cruunnerr/CrallyBoard/3D Animated Pictures/01_Top.png

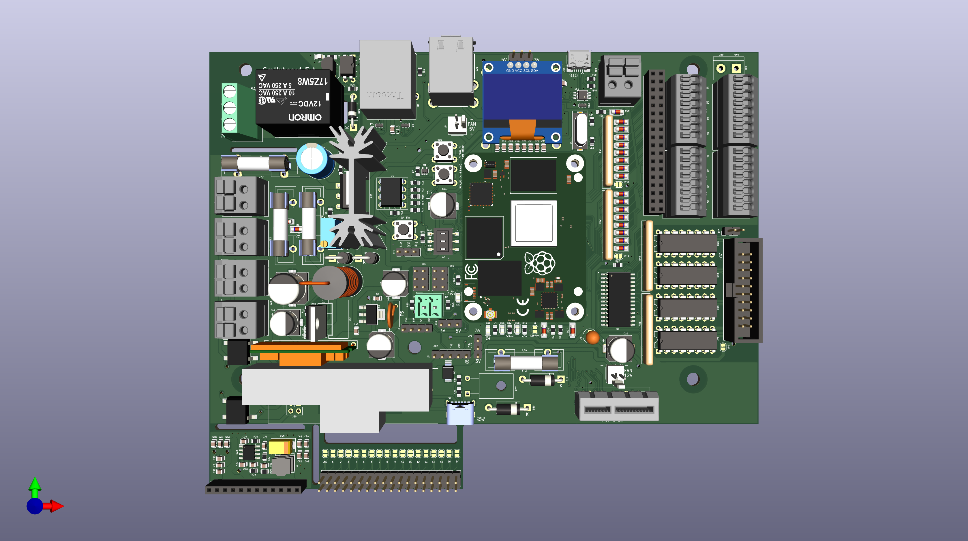
3D Animated Pictures/01_Top.png
