cruunnerr/CrallyBoard/3D Animated Pictures/03_Inputs:Outputs.png

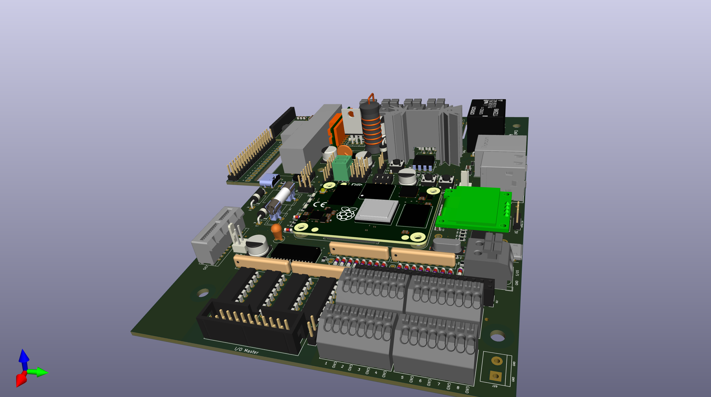
3D Animated Pictures/03_Inputs:Outputs.png
