cruunnerr/CrallyBoard/3D Animated Pictures/02_Main_Connectors.png

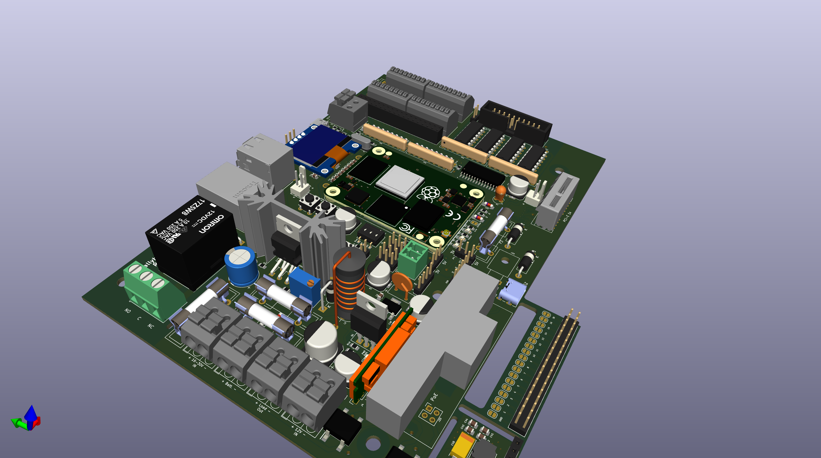
3D Animated Pictures/02_Main_Connectors.png
