cruunnerr/CrallyBoard/3D Animated Pictures/04_Data_Connectors.png

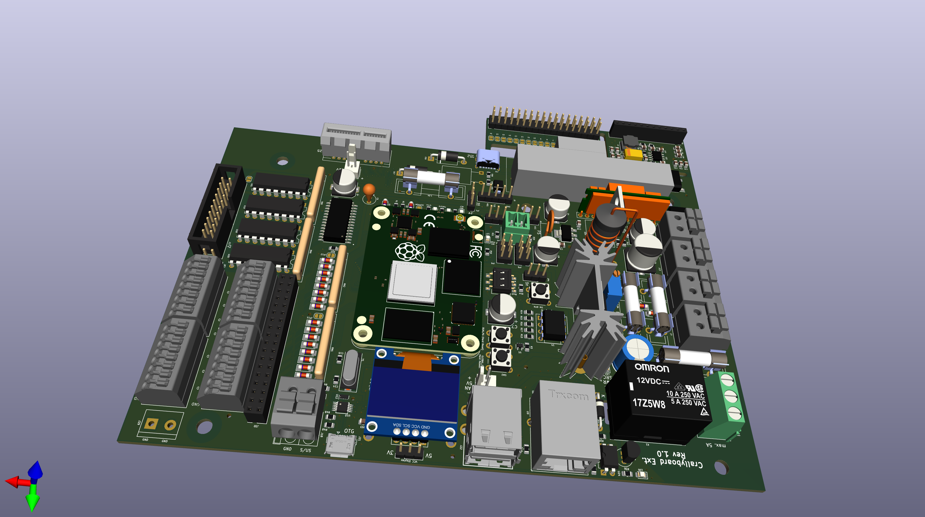
3D Animated Pictures/04_Data_Connectors.png
