cruunnerr/CrallyBoard/3D Animated Pictures/05_Backside.png

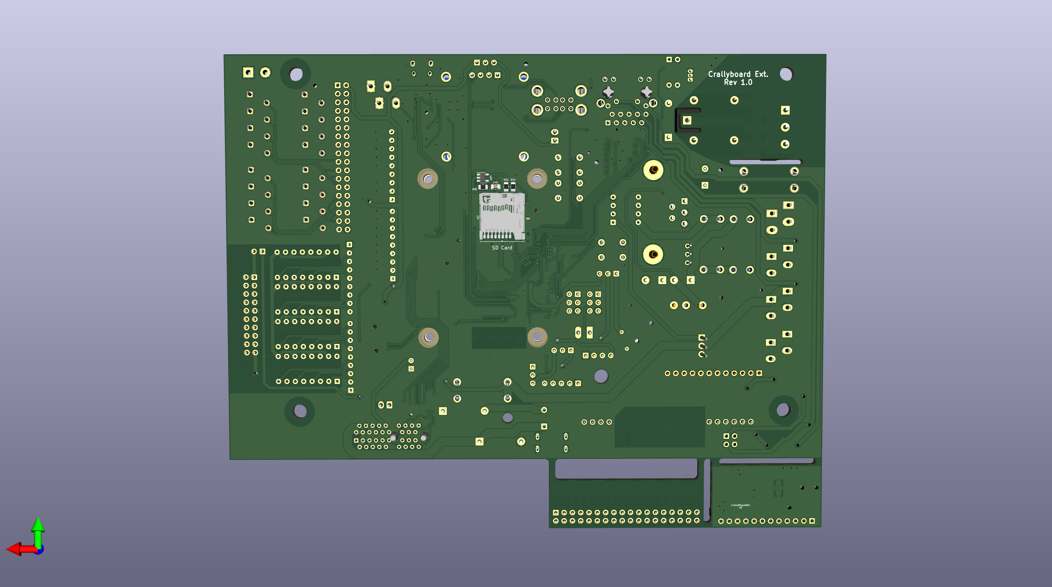
3D Animated Pictures/05_Backside.png
