cruunnerr/CrallyBoard/cam_server-Assembly.pdf

1 | 2 | 3 | 4 | 5 | 6 1 | 2 | 3 | 4 | 5 | 6 ABCD | ABCD Date: 2022-10-13 KiCad E.D.A. kicad (6.0.4-0) Size: A4 | Rev: 1.0
100uF C45 | 220R | R³ Jumper_2_Bridged G⁵LE⁻¹ | K¹

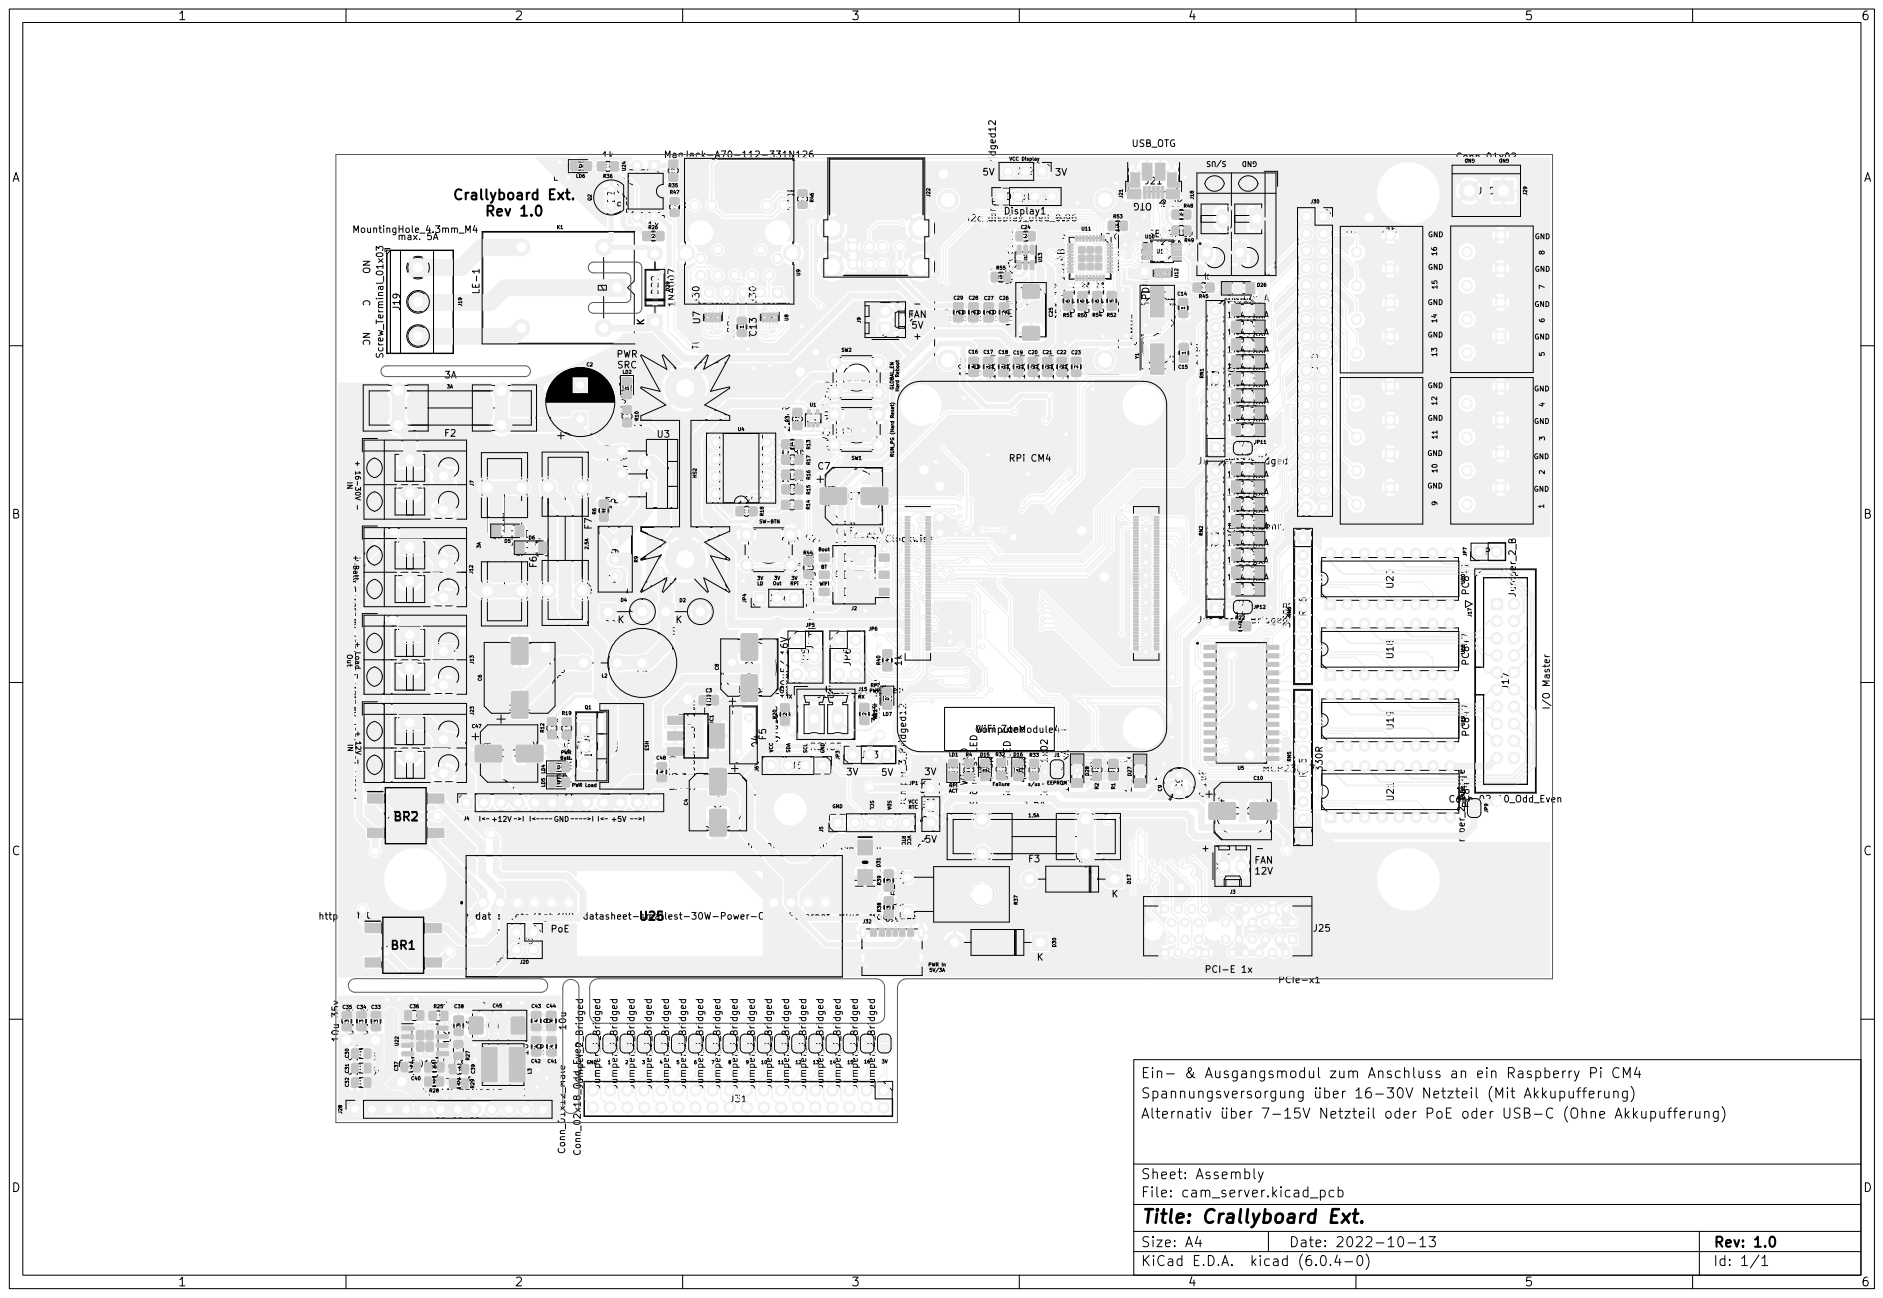
[picture p6: page 1]

EEPROM Crallyboard Ext. Rev 1.0

s/us RUN_PG ⁽Hard Reset) max. 5A

GND GND ⁺ ¹⁶⁻³0V - IN

https://silvertel.com/images/datasheets/Ag5300-datasheet-smallest-30W-Power-Over-Ethernet-Plus-Module-PoEplusPD.pdf U25

Ein- & Ausgangsmodul zum Anschluss an ein Raspberry Pi CM4
Spannungsversorgung über 16-30V Netzteil (Mit Akkupufferung)
Alternativ über 7-15V Netzteil oder PoE oder USB-C (Ohne Akkupufferung)

Sheet: Assembly
File: cam_server.kicad_pcb
Id: 1/1 Title: Crallyboard Ext.

1 | 2 | 3 | 4 | 5 | 6

A

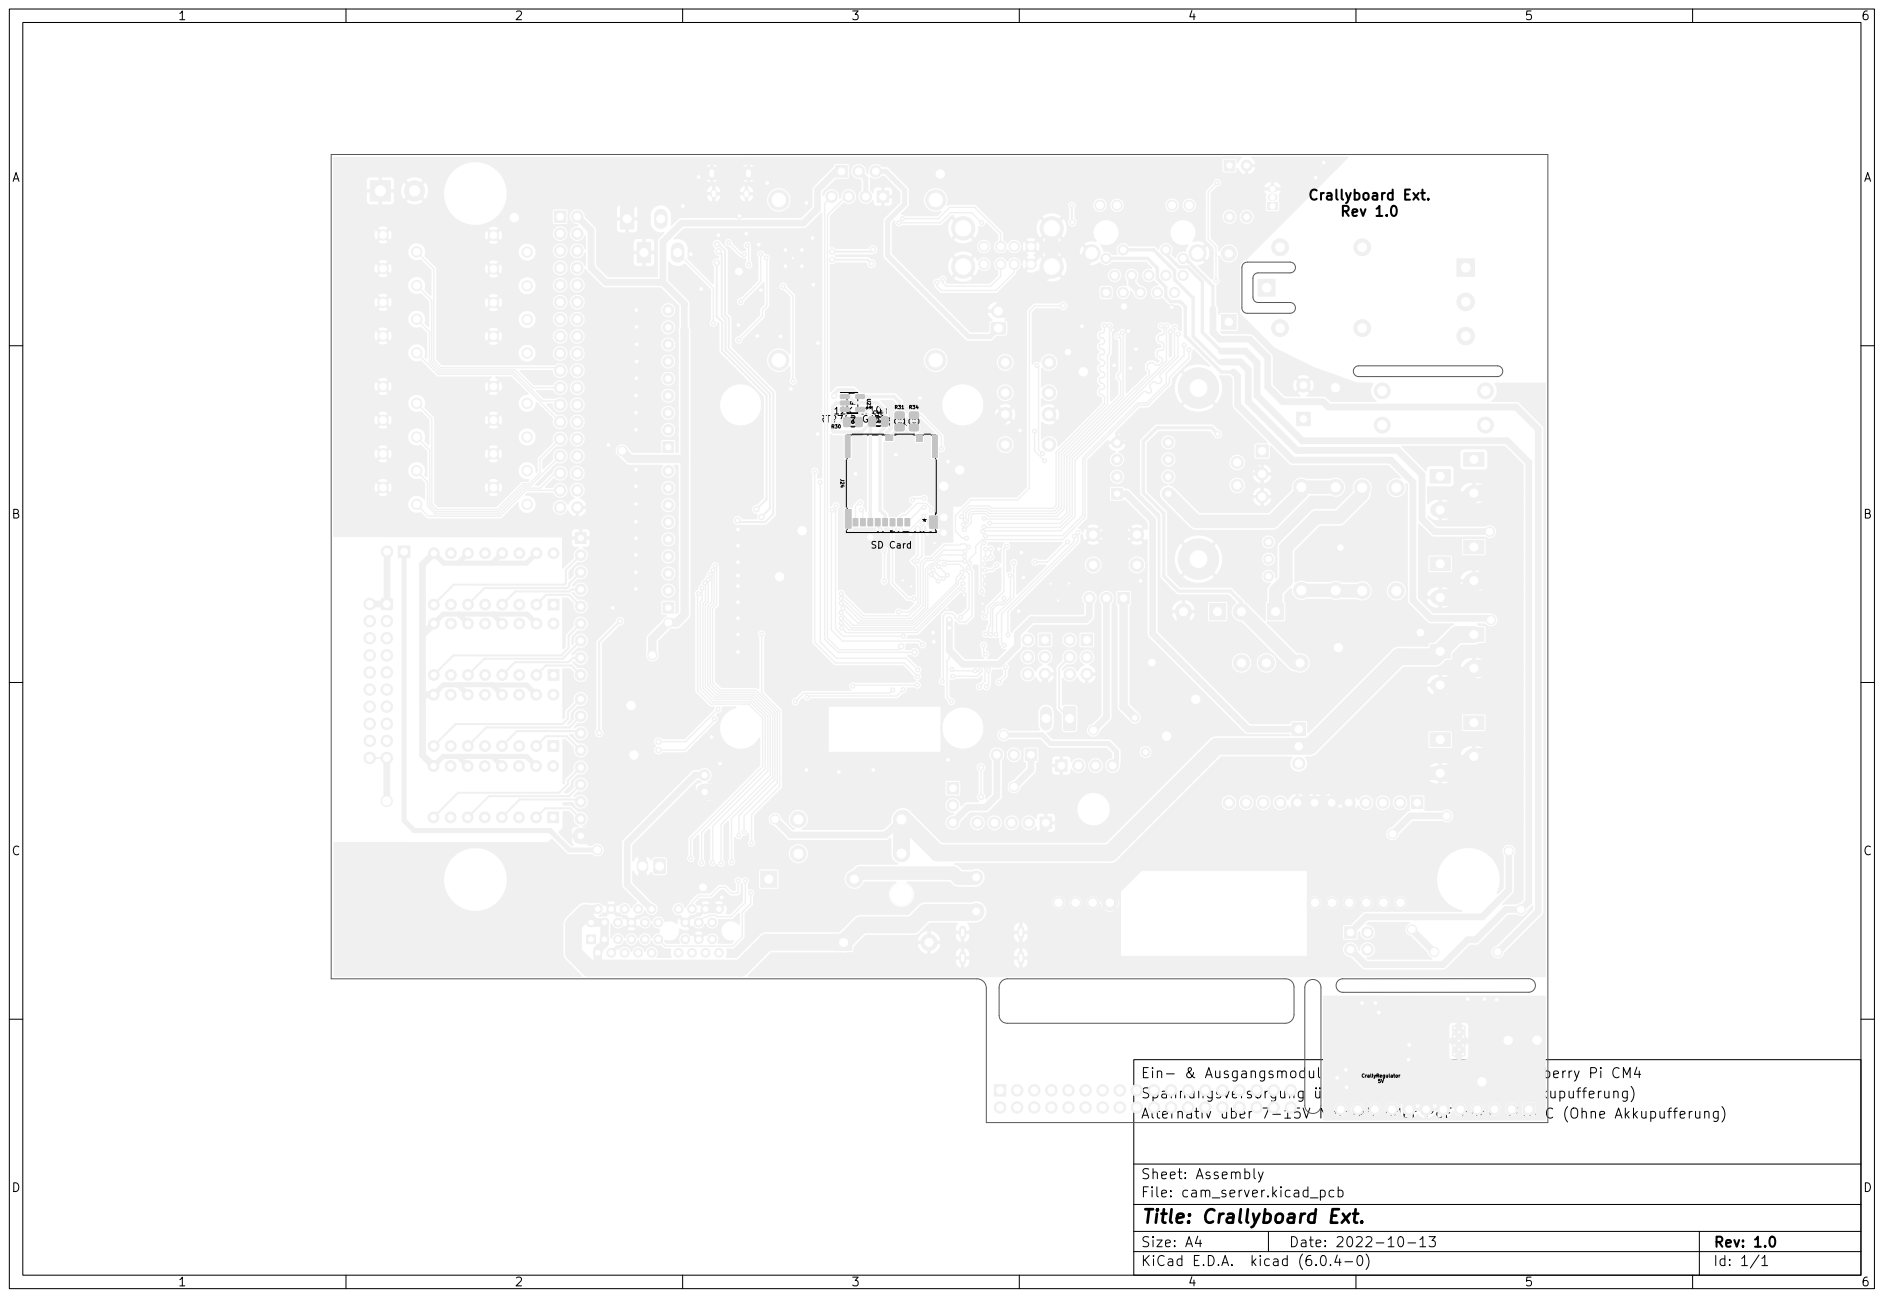
[picture p7: page 2]
D Date: 2022-10-13 KiCad E.D.A. kicad (6.0.4-0) Size: A4; Rev: 1.0; R34RT9742AGJ5F; CrallyRegulator 5V; SD Card; Crallyboard Ext. Rev 1.0

Ein- & Ausgangsmodul zum Anschluss an ein Raspberry Pi CM4
Spannungsversorgung über 16-30V Netzteil (Mit Akkupufferung)
Alternativ über 7-15V Netzteil oder PoE oder USB-C (Ohne Akkupufferung)

Sheet: Assembly
File: cam_server.kicad_pcb
Id: 1/1 Title: Crallyboard Ext.

1 | 2 | 3 | 4 | 5 | 6 1 | 2 | 3 | 4 | 5 | 6 ABCD | ABCD Date: 2022-10-13 KiCad E.D.A. kicad (6.0.4-0) Size: A4 | Rev: 1.0
100uF C45 | 220R | R³ Jumper_2_Bridged G⁵LE⁻¹ | K¹

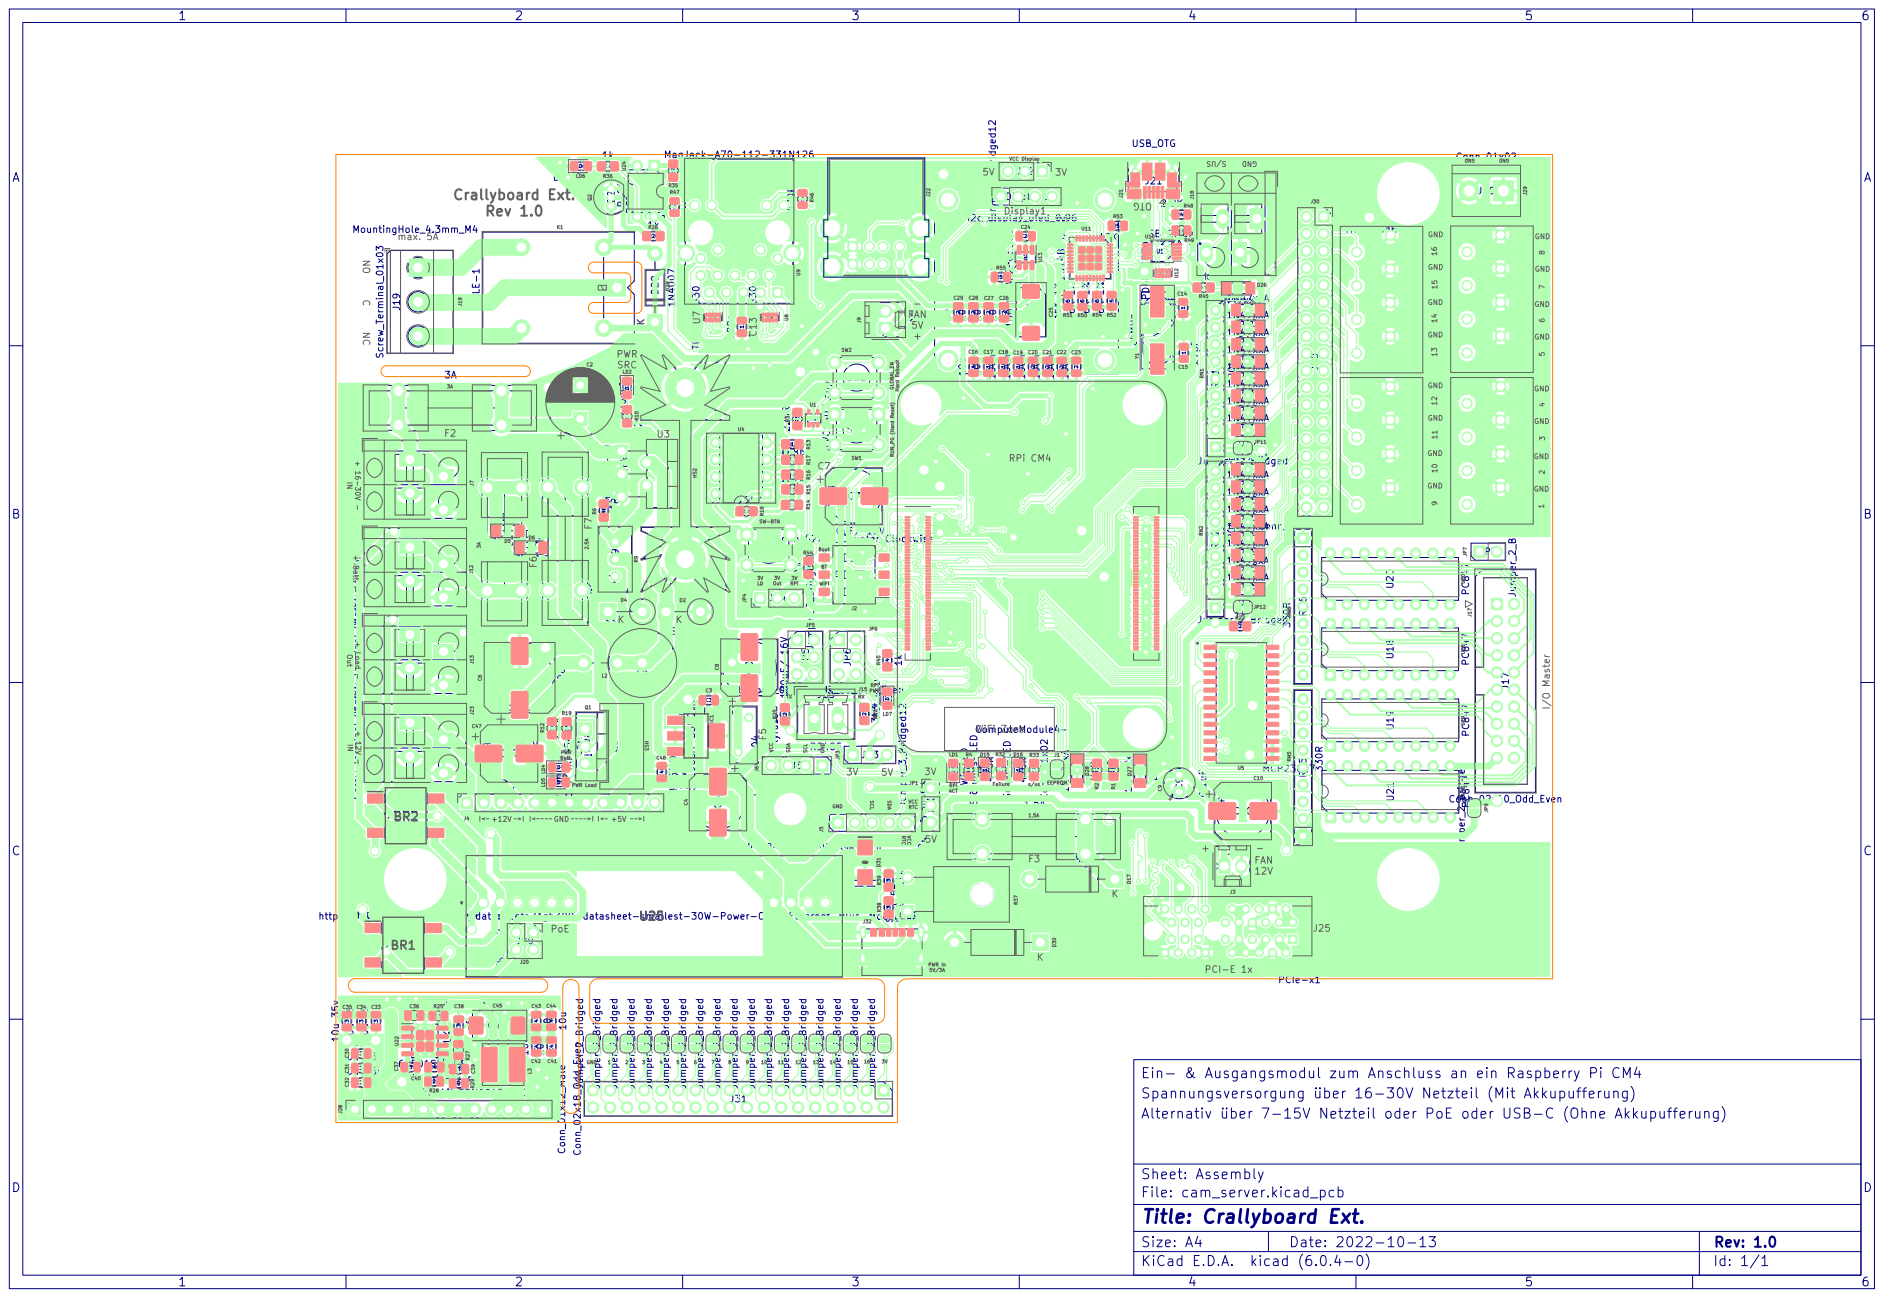
[picture p8: page 3]

EEPROM Crallyboard Ext. Rev 1.0

s/us RUN_PG ⁽Hard Reset) max. 5A

GND GND ⁺ ¹⁶⁻³0V - IN

https://silvertel.com/images/datasheets/Ag5300-datasheet-smallest-30W-Power-Over-Ethernet-Plus-Module-PoEplusPD.pdf U25

Ein- & Ausgangsmodul zum Anschluss an ein Raspberry Pi CM4
Spannungsversorgung über 16-30V Netzteil (Mit Akkupufferung)
Alternativ über 7-15V Netzteil oder PoE oder USB-C (Ohne Akkupufferung)

Sheet: Assembly
File: cam_server.kicad_pcb
Id: 1/1 Title: Crallyboard Ext.

1 | 2 | 3 | 4 | 5 | 6

A

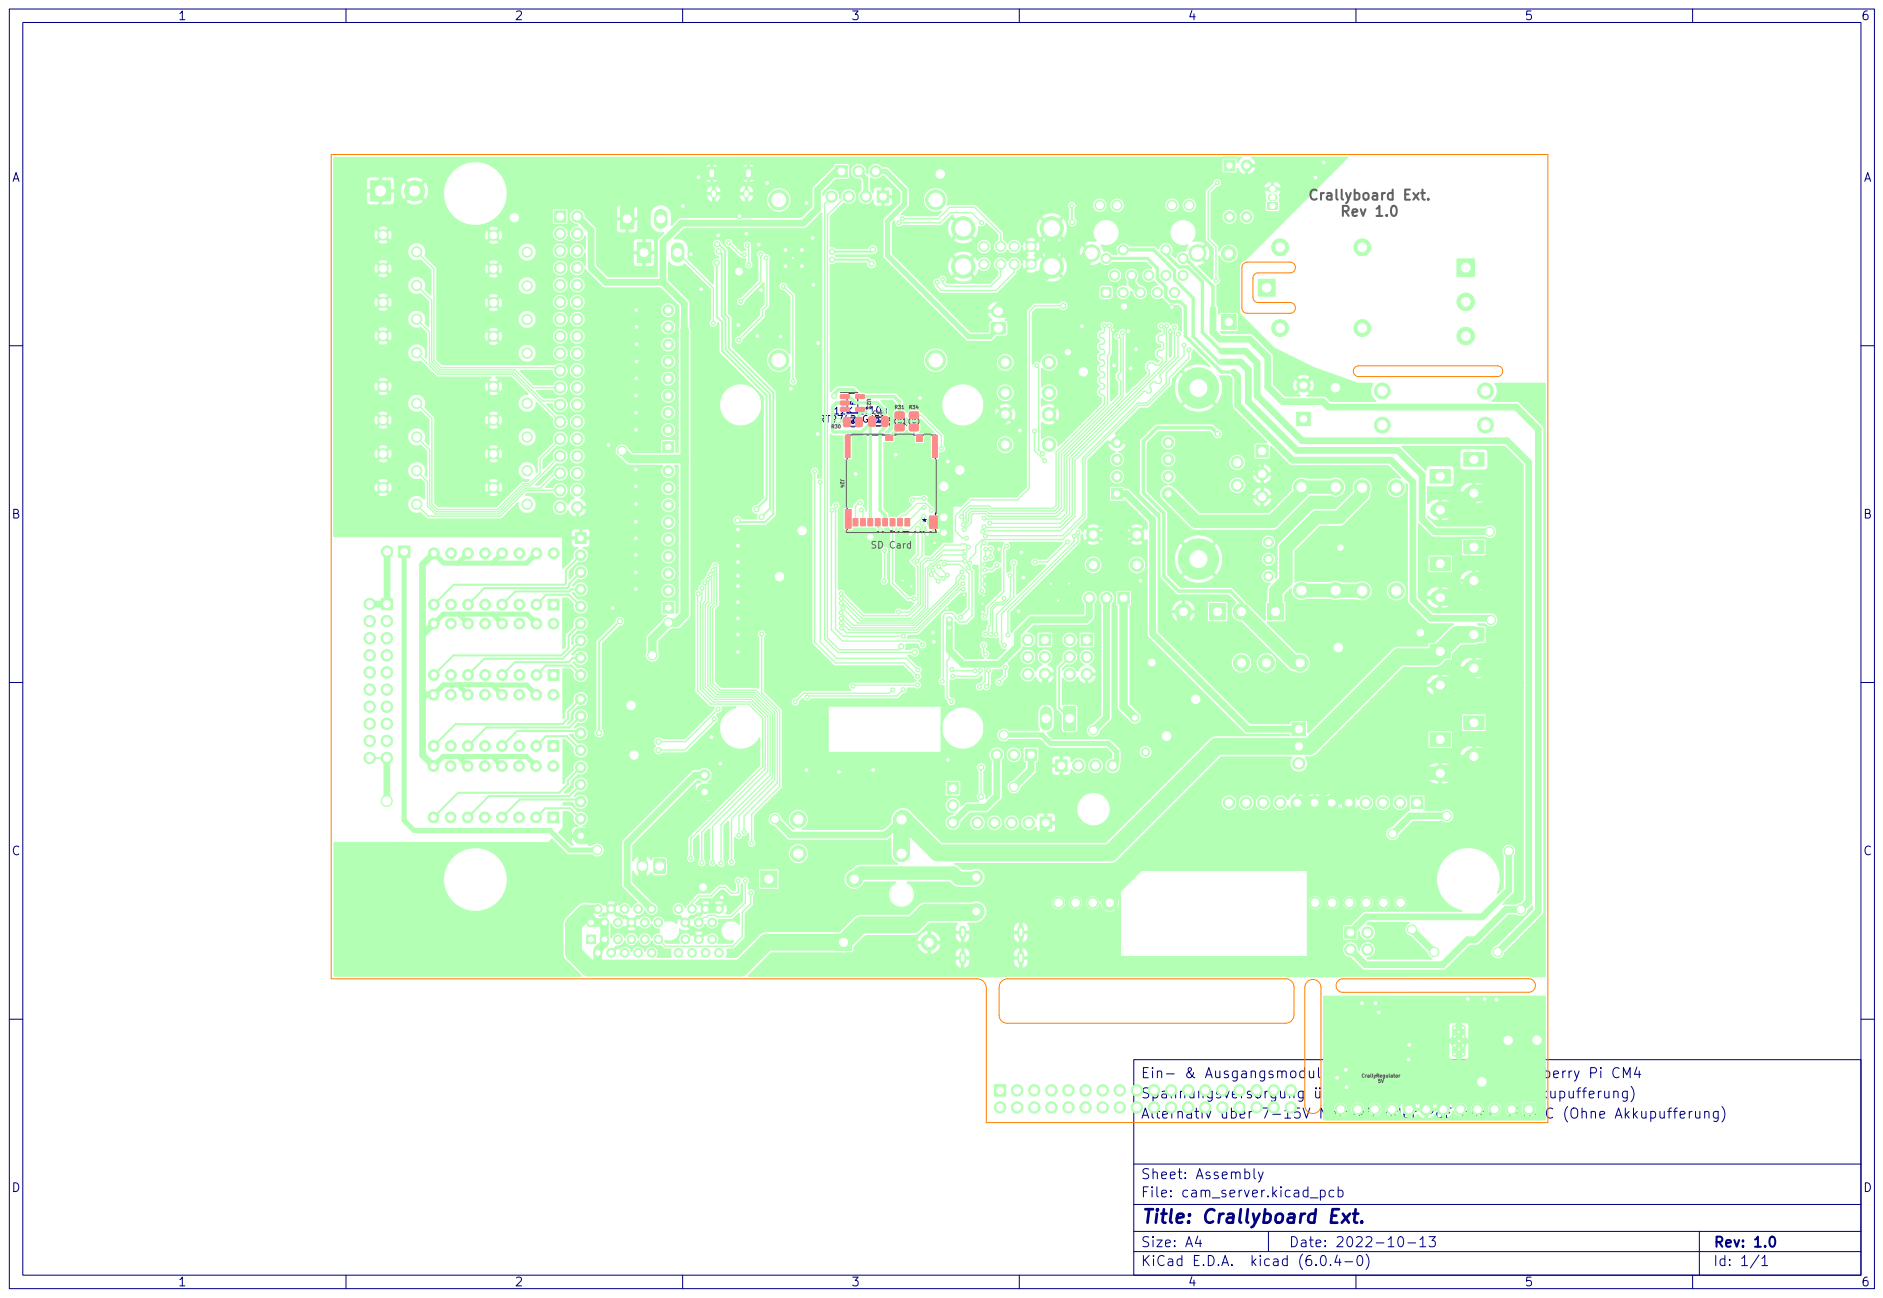
[picture p9: page 4]
D Date: 2022-10-13 KiCad E.D.A. kicad (6.0.4-0) Size: A4; Rev: 1.0; R34RT9742AGJ5F; CrallyRegulator 5V; SD Card; Crallyboard Ext. Rev 1.0

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

Sheet: Assembly
File: cam_server.kicad_pcb
Id: 1/1 Title: Crallyboard Ext.

SD Card | Crallyboard Ext. Rev 1.0

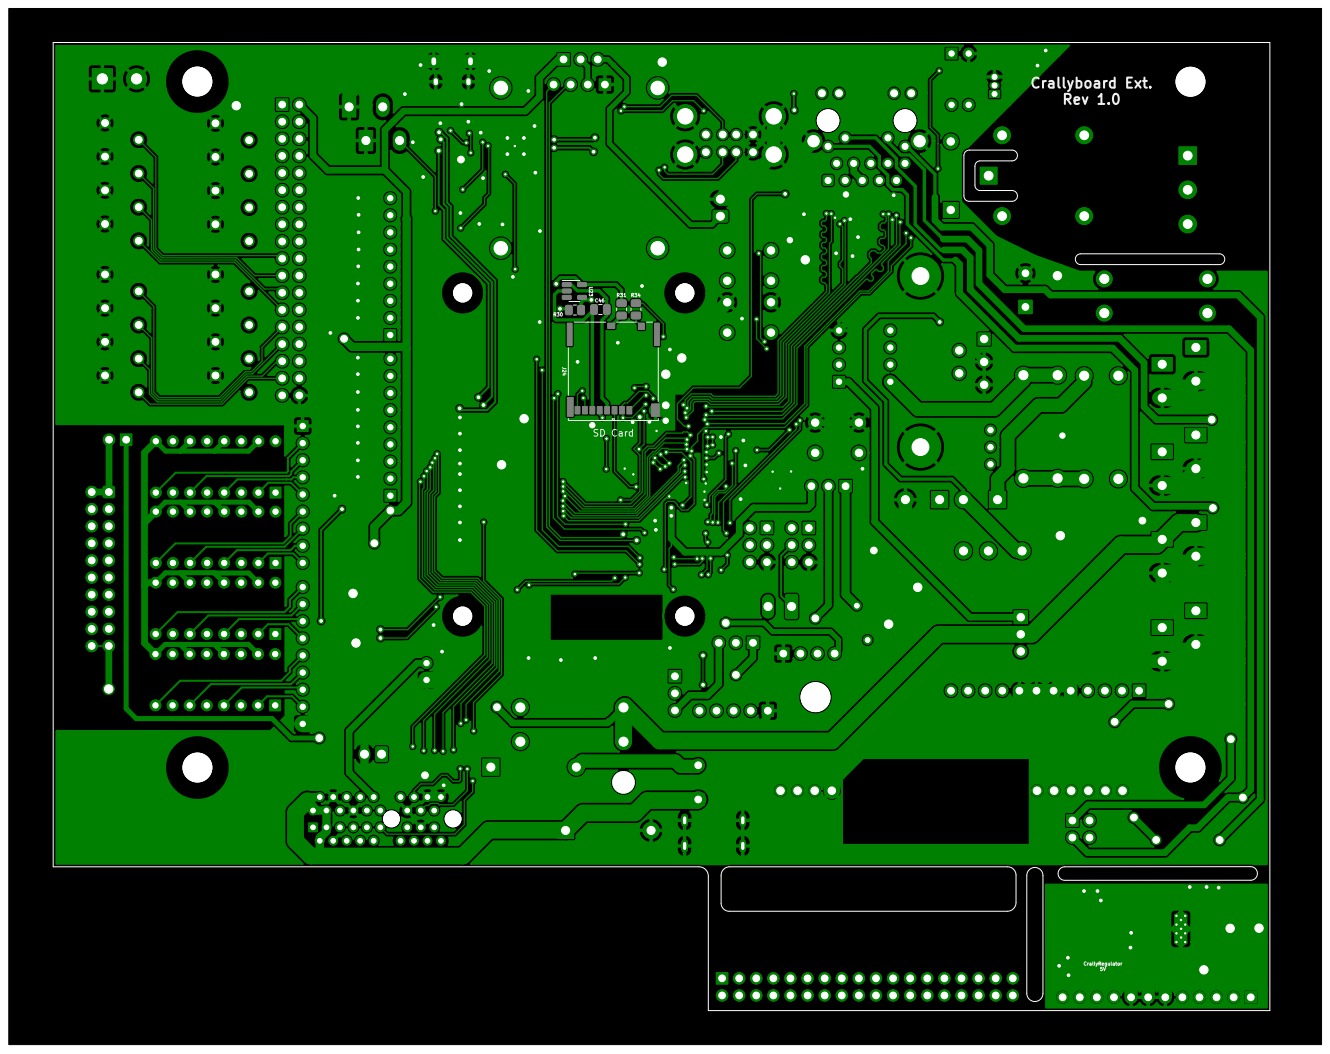
[picture p10: page 5]
R34RT9742AGJ5F; CrallyRegulator 5V

100uF C45 | 220R | R³ Jumper_2_Bridged G⁵LE⁻¹ | K¹

## GND GND

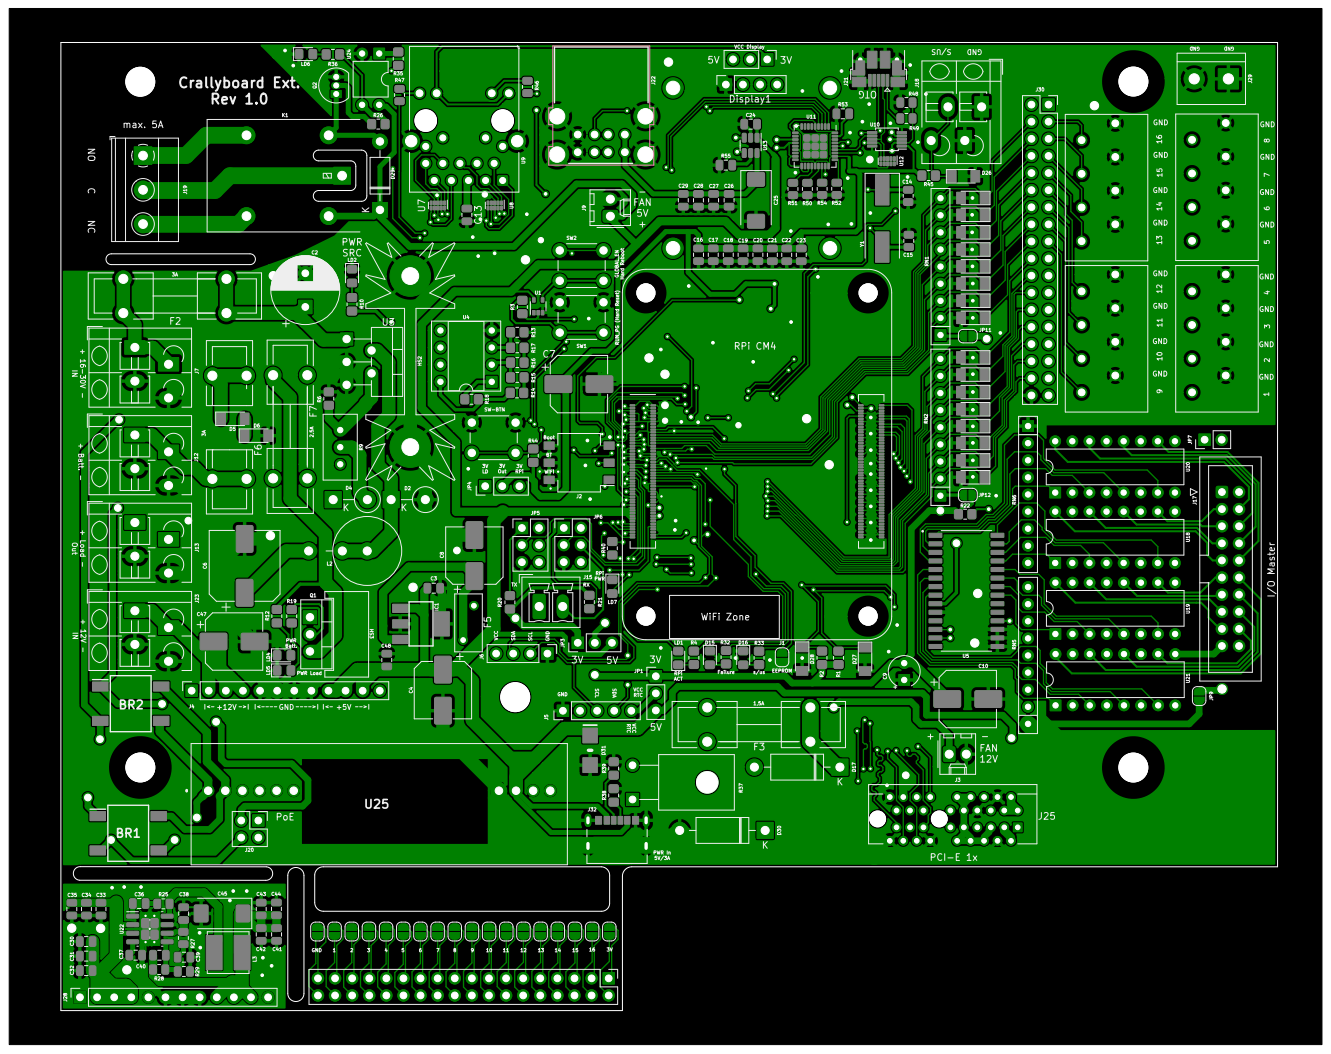
[picture p11: page 6]

EEPROM Crallyboard Ext. Rev 1.0

s/us RUN_PG ⁽Hard Reset) max. 5A

GND GND ⁺ ¹⁶⁻³0V - IN

https://silvertel.com/images/datasheets/Ag5300-datasheet-smallest-30W-Power-Over-Ethernet-Plus-Module-PoEplusPD.pdf U25
