cruunnerr/CrallyBoard/kicad files/cam_server.kicad_sch

## KiCad design kicad files/cam_server.kicad_sch (2022-10-13)

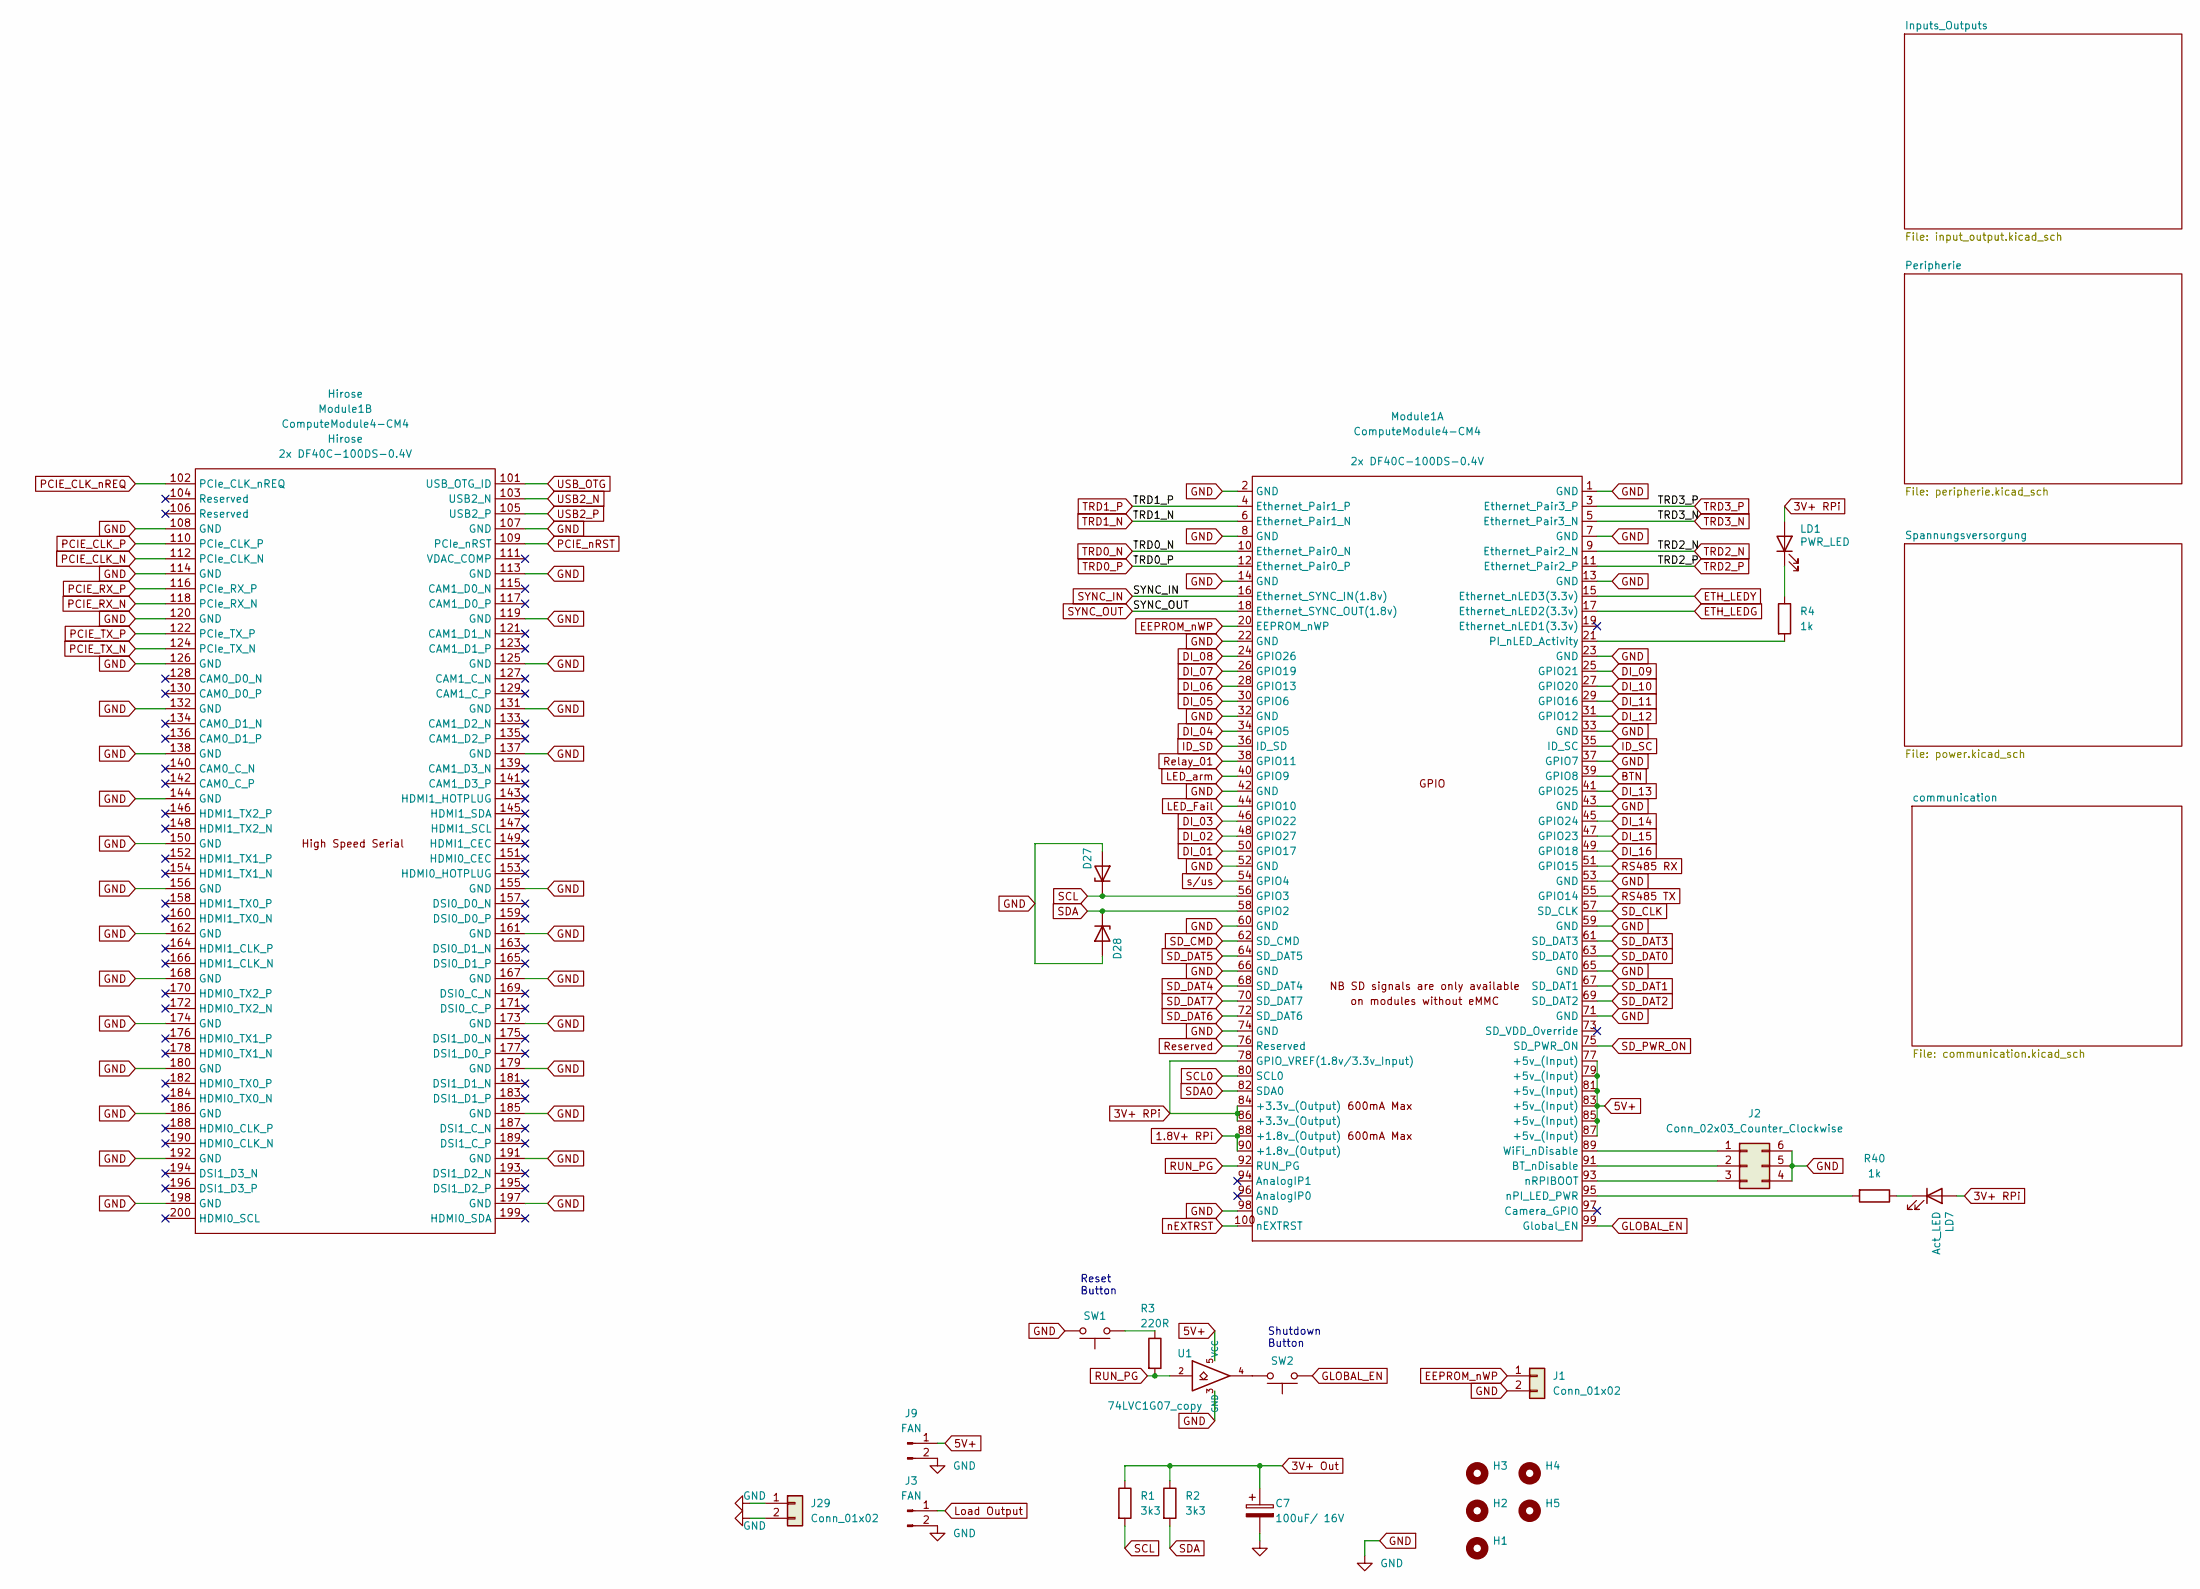
[picture p12: schematic cam_server.kicad_sch]

Parts:
C7: 100uF/ 16V; CP_Elec_8x6.2; Mouser Part Number 667-EEE-1CA101P
D27, D28: 1N47xxA; D_MiniMELF
H1, H2, H3, H4, H5: MountingHole_4.3mm_M4
J1: Conn_01x02; SolderJumper-2_P1.3mm_Open_RoundedPad1.0x1.5mm
J2: Conn_02x03_Counter_Clockwise; SW_DIP_SPSTx03_Slide_Omron_A6S-310x_W8.9mm_P2.54mm; Mouser Part Number 653-A6S-3102-PH
J3, J9: FAN; Molex_KK-254_AE-6410-02A_1x02_P2.54mm_Vertical; Mouser Part Number 538-22-27-2021
J29: Conn_01x02; TerminalBlock_bornier-2_P5.08mm
LD1: PWR_LED; LED_0805_2012Metric_Pad1.15x1.40mm_HandSolder; Mouser Part Number 604-APTD2012LCGCK
LD7: Act_LED; LED_0805_2012Metric_Pad1.15x1.40mm_HandSolder; Mouser Part Number 604-APTD2012LCGCK
Module1: ComputeModule4-CM4; Raspberry-Pi-4-Compute-Module; Mouser Part Number 798-DF40C100DS0.4V58
R1, R2: 3k3; R_0805_2012Metric_Pad1.20x1.40mm_HandSolder; Mouser Part Number 603-RC0805FR-103K3L
R3: 220R; R_0805_2012Metric_Pad1.20x1.40mm_HandSolder; Mouser Part Number 603-RC0805FR-13220RL
R4, R40: 1k; R_0805_2012Metric_Pad1.20x1.40mm_HandSolder; Mouser Part Number 603-RC0805FR-131KL
SW1, SW2: SW_PUSH_6mm_H5mm; Mouser Part Number 179-TS026660BK160SCR
U1: 74LVC1G07_copy; SOT-353_SC-70-5; Mouser Part Number 595-SN74LVC1G07DCKT

Connections:
1.8V+ RPi: Module1.88 (+1.8v_(Output)), Module1.90 (+1.8v_(Output))
3V+ Out: C7.1, R1.1, R2.1
3V+ RPi: LD1.2 (A), LD7.2 (A), Module1.78 (GPIO_VREF(1.8v/3.3v_Input)), Module1.84 (+3.3v_(Output)), Module1.86 (+3.3v_(Output))
5V+: J9.1, Module1.77 (+5v_(Input)), Module1.79 (+5v_(Input)), Module1.81 (+5v_(Input)), Module1.83 (+5v_(Input)), Module1.85 (+5v_(Input)), Module1.87 (+5v_(Input)), U1.5 (VCC)
BTN: Module1.39 (GPIO8)
DI_01: Module1.50 (GPIO17)
DI_02: Module1.48 (GPIO27)
DI_03: Module1.46 (GPIO22)
DI_04: Module1.34 (GPIO5)
DI_05: Module1.30 (GPIO6)
DI_06: Module1.28 (GPIO13)
DI_07: Module1.26 (GPIO19)
DI_08: Module1.24 (GPIO26)
DI_09: Module1.25 (GPIO21)
DI_10: Module1.27 (GPIO20)
DI_11: Module1.29 (GPIO16)
DI_12: Module1.31 (GPIO12)
DI_13: Module1.41 (GPIO25)
DI_14: Module1.45 (GPIO24)
DI_15: Module1.47 (GPIO23)
DI_16: Module1.49 (GPIO18)
EEPROM_nWP: J1.1, Module1.20 (EEPROM_nWP)
ETH_LEDG: Module1.17 (Ethernet_nLED2(3.3v))
ETH_LEDY: Module1.15 (Ethernet_nLED3(3.3v))
GLOBAL_EN: Module1.99 (Global_EN), SW2.1
GND: C7.2, D27.2 (A), D28.2 (A), J1.2, J2.4, J2.5, J2.6, J3.2, J9.2, J29.1, J29.2, Module1.1 (GND), Module1.2 (GND), Module1.7 (GND), Module1.8 (GND), Module1.13 (GND), Module1.14 (GND), Module1.22 (GND), Module1.23 (GND), Module1.32 (GND), Module1.33 (GND), Module1.37 (GPIO7), Module1.42 (GND), Module1.43 (GND), Module1.52 (GND), Module1.53 (GND), Module1.59 (GND), Module1.60 (GND), Module1.65 (GND), Module1.66 (GND), Module1.71 (GND), Module1.74 (GND), Module1.98 (GND), Module1.107 (GND), Module1.108 (GND), Module1.113 (GND), Module1.114 (GND), Module1.119 (GND), Module1.120 (GND), Module1.125 (GND), Module1.126 (GND), Module1.131 (GND), Module1.132 (GND), Module1.137 (GND), Module1.138 (GND), Module1.144 (GND), Module1.150 (GND), Module1.155 (GND), Module1.156 (GND), Module1.161 (GND), Module1.162 (GND), Module1.167 (GND), Module1.168 (GND), Module1.173 (GND), Module1.174 (GND), Module1.179 (GND), Module1.180 (GND), Module1.185 (GND), Module1.186 (GND), Module1.191 (GND), Module1.192 (GND), Module1.197 (GND), Module1.198 (GND), SW1.2, U1.3 (GND)
ID_SC: Module1.35 (ID_SC)
ID_SD: Module1.36 (ID_SD)
LED_Fail: Module1.44 (GPIO10)
LED_arm: Module1.40 (GPIO9)
Load Output: J3.1
unnamed: J2.1, Module1.89 (WiFi_nDisable)
unnamed: J2.2, Module1.91 (BT_nDisable)
unnamed: J2.3, Module1.93 (nRPIBOOT)
unnamed: LD1.1 (K), R4.1
unnamed: LD7.1 (K), R40.1
unnamed: Module1.21 (PI_nLED_Activity), R4.2
unnamed: Module1.95 (nPI_LED_PWR), R40.2
unnamed: R3.1, SW1.1
unnamed: SW2.2, U1.4
PCIE_CLK_N: Module1.112 (PCIe_CLK_N)
PCIE_CLK_P: Module1.110 (PCIe_CLK_P)
PCIE_CLK_nREQ: Module1.102 (PCIe_CLK_nREQ)
PCIE_RX_N: Module1.118 (PCIe_RX_N)
PCIE_RX_P: Module1.116 (PCIe_RX_P)
PCIE_TX_N: Module1.124 (PCIe_TX_N)
PCIE_TX_P: Module1.122 (PCIe_TX_P)
PCIE_nRST: Module1.109 (PCIe_nRST)
RS485 RX: Module1.51 (GPIO15)
RS485 TX: Module1.55 (GPIO14)
RUN_PG: Module1.92 (RUN_PG), R3.2, U1.2
Relay_01: Module1.38 (GPIO11)
Reserved: Module1.76 (Reserved)
SCL: D27.1 (K), Module1.56 (GPIO3), R1.2
SCL0: Module1.80 (SCL0)
SDA: D28.1 (K), Module1.58 (GPIO2), R2.2
SDA0: Module1.82 (SDA0)
SD_CLK: Module1.57 (SD_CLK)
SD_CMD: Module1.62 (SD_CMD)
SD_DAT0: Module1.63 (SD_DAT0)
SD_DAT1: Module1.67 (SD_DAT1)
SD_DAT2: Module1.69 (SD_DAT2)
SD_DAT3: Module1.61 (SD_DAT3)
SD_DAT4: Module1.68 (SD_DAT4)
SD_DAT5: Module1.64 (SD_DAT5)
SD_DAT6: Module1.72 (SD_DAT6)
SD_DAT7: Module1.70 (SD_DAT7)
SD_PWR_ON: Module1.75 (SD_PWR_ON)
SYNC_IN: Module1.16 (Ethernet_SYNC_IN(1.8v))
SYNC_OUT: Module1.18 (Ethernet_SYNC_OUT(1.8v))
TRD0_N: Module1.10 (Ethernet_Pair0_N)
TRD0_P: Module1.12 (Ethernet_Pair0_P)
TRD1_N: Module1.6 (Ethernet_Pair1_N)
TRD1_P: Module1.4 (Ethernet_Pair1_P)
TRD2_N: Module1.9 (Ethernet_Pair2_N)
TRD2_P: Module1.11 (Ethernet_Pair2_P)
TRD3_N: Module1.5 (Ethernet_Pair3_N)
TRD3_P: Module1.3 (Ethernet_Pair3_P)
USB2_N: Module1.103 (USB2_N)
USB2_P: Module1.105 (USB2_P)
USB_OTG: Module1.101 (USB_OTG_ID)
nEXTRST: Module1.100 (nEXTRST)
s/us: Module1.54 (GPIO4)

Notes on the sheet:
Reset Button
Shutdown Button
