cruunnerr/CrallyBoard/kicad files/communication.kicad_sch

## KiCad design kicad files/communication.kicad_sch (2022-10-13)

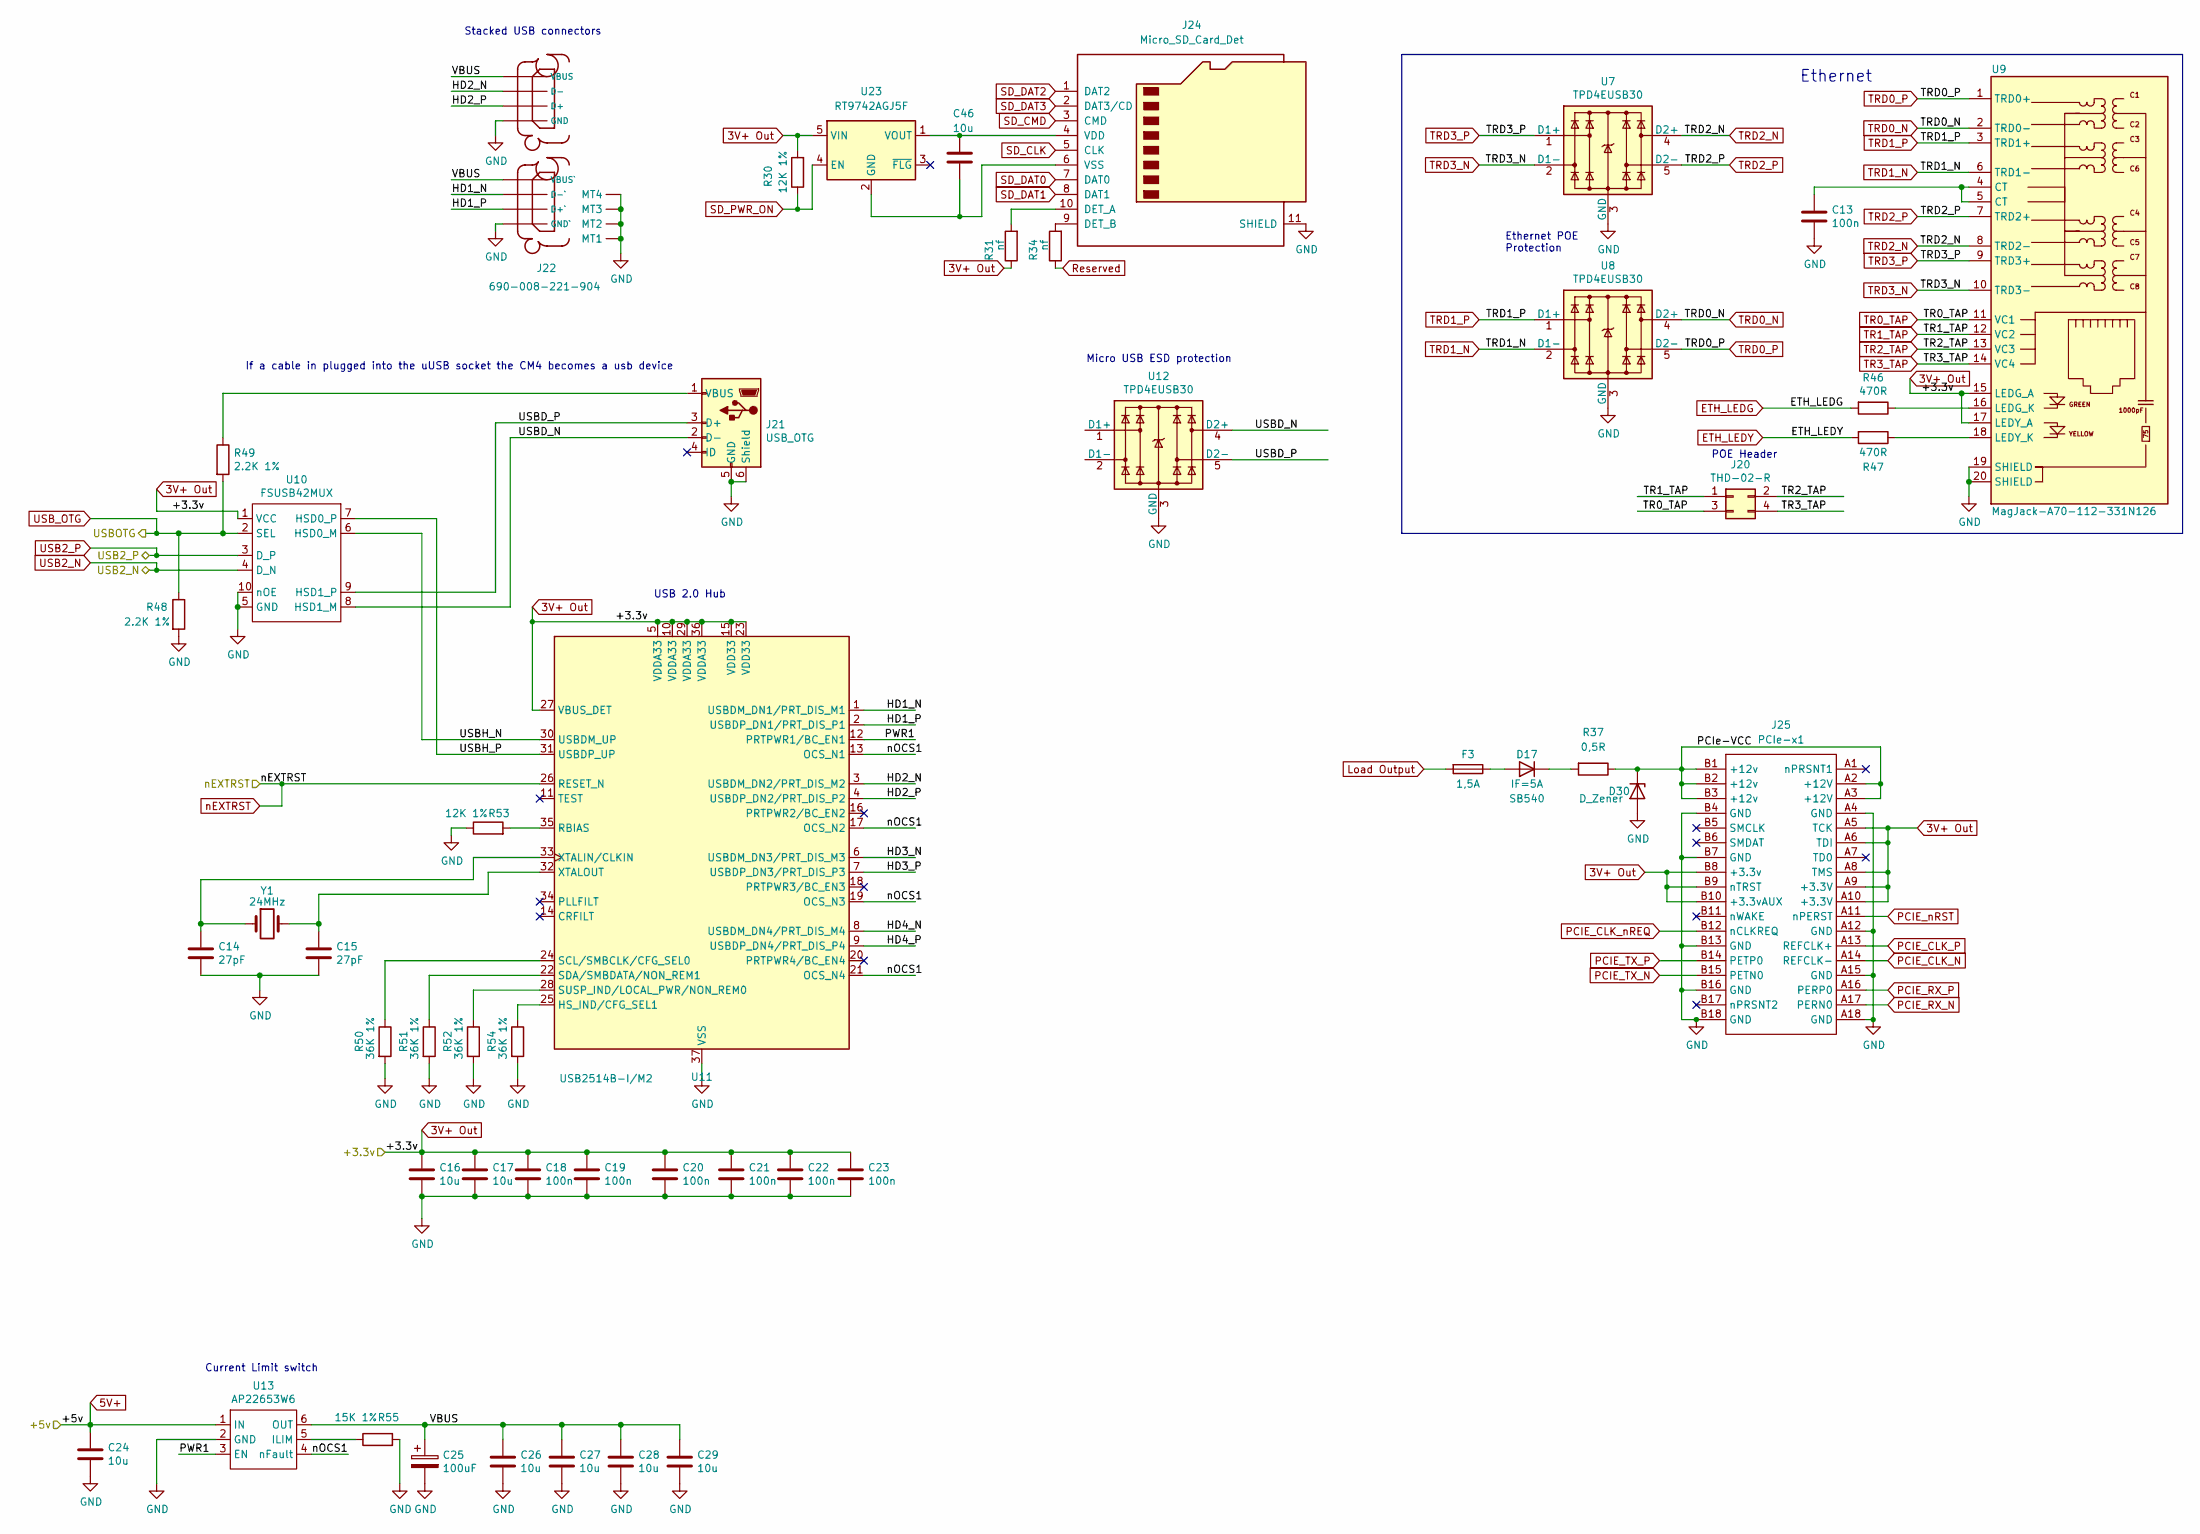
[picture p13: schematic communication.kicad_sch]

Parts:
C13, C18, C19, C20, C21, C22, C23: 100n; C_0805_2012Metric; Part Description 0.1uF 10% 16V Ceramic Capacitor X7R 040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
C14, C15: 27pF; R_0805_2012Metric; Part Description 27pF 5% 50V Ceramic Capacitor C0G, NP0 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
C16, C17, C24, C26, C27, C28, C29, C46: 10u; C_0805_2012Metric; Part Description 10uF 10% 10V Ceramic Capacitor X7R 0805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
C25: 100uF; CP_EIA-7343-31_Kemet-D; Part Description Capacitor, SP-Cap, 100u, 6.3V, 15mR ESR
D17: IF=5A; D_DO-15_P12.70mm_Horizontal
D30: D_Zener; D_DO-15_P12.70mm_Horizontal
F3: 1,5A; Fuseholder5x20_horiz_open_lateral_Type-II
J20: THD-02-R; PinHeader_2x02_P2.54mm_Vertical; Part Description PinHeader_2x02_P2.54mm_Vertical
J21: USB_OTG; USB_Micro-B_EDAC_UCON00686; Part Description USB - micro B USB 2.0 Receptacle Connec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
J22: 690-008-221-904; MOLEX_USB_67298-4090; Part Description USB-A (USB TYPE-A), Stacked Receptacle 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; Mouser Part Number 538-67298-4090
J24: Micro_SD_Card_Det; 5033981892
J25: PCIe-x1; PCIex1-36
R30: 12K 1%; R_0805_2012Metric; Part Description Resistor 15K M1005 1% 63mW
R31, R34: nf; R_0805_2012Metric; Part Description Resistor 1K M1005 1% 63mW
R37: 0,5R; TO-126-2_Horizontal_TabUp
R46, R47: 470R; R_0805_2012Metric; Part Description Resistor 470R M1005 1% 63mW
R48, R49: 2.2K 1%; R_0805_2012Metric; Part Description Resistor 2.2K M1005 1% 63mW
R50, R51, R52, R54: 36K 1%; R_0805_2012Metric; Part Description Resistor 36K M1005 1% 63mW
R53: 12K 1%; C_0805_2012Metric; Part Description Resistor 12K M1005 1% 63mW
R55: 15K 1%; C_0805_2012Metric; Part Description Resistor 15K M1005 1% 63mW
U7, U8, U12: TPD4EUSB30; USON-10_2.5x1.0mm_P0.5mm; Part Description Quad TVS diode for high speed signals (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
U9: MagJack-A70-112-331N126; TRJG0926HENL; Part Description Gigabit Ethernet Magjack
U10: FSUSB42MUX; MSOP-10_3x3mm_P0.5mm; Part Description USB Switch IC 1 Channel 10-MSOP
U11: USB2514B-I/M2; QFN-36-1EP_6x6mm_P0.5mm_EP3.7x3.7mm; Part Description USB Hub Controller USB Interface 36-SQF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
U13: AP22653W6; SOT-23-6; Part Description Power Switch/Driver 1:1 P-Channel 2.1A 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
U23: RT9742AGJ5F; TSOT-23-5
Y1: 24MHz; Crystal_SMD_HC49-SD; Part Description 24MHz Crystal 18pf 30ppm 30ppm

Connections:
3V+ Out: C16.1, C17.1, C18.1, C19.1, C20.1, C21.1, C22.1, C23.1, J25.A5 (TCK), J25.A6 (TDI), J25.A8 (TMS), J25.A9 (+3.3V), J25.A10 (+3.3V), J25.B8 (+3.3v), J25.B9 (nTRST), J25.B10 (+3.3vAUX), R30.2, R31.1, U9.15 (LEDG_A), U9.17 (LEDY_A), U10.1 (VCC), U11.5 (VDDA33), U11.10 (VDDA33), U11.15 (VDD33), U11.23 (VDD33), U11.27 (VBUS_DET), U11.29 (VDDA33), U11.36 (VDDA33), U23.5 (VIN)
5V+: C24.1, U13.1 (IN)
ETH_LEDG: R46.2
ETH_LEDY: R47.2
GND: C13.2, C14.2, C15.2, C16.2, C17.2, C18.2, C19.2, C20.2, C21.2, C22.2, C23.2, C24.2, C25.2, C26.2, C27.2, C28.2, C29.2, D30.2 (A), J21.5 (GND), J21.6 (Shield), J22.4 (GND`), J22.8 (GND), J22.MT1, J22.MT2, J22.MT3, J22.MT4, J24.11 (SHIELD), J25.A4 (GND), J25.A12 (GND), J25.A15 (GND), J25.A18 (GND), J25.B4 (GND), J25.B7 (GND), J25.B13 (GND), J25.B16 (GND), J25.B18 (GND), R48.2, R50.2, R51.2, R52.2, R53.1, R54.2, R55.2, U7.3 (GND), U7.8 (GND), U8.3 (GND), U8.8 (GND), U9.19 (SHIELD), U9.20 (SHIELD), U10.5 (GND), U10.10 (nOE), U11.37 (VSS), U12.3 (GND), U12.8 (GND), U13.2 (GND)
HD1_N: J22.2 (D-`), U11.1 (USBDM_DN1/PRT_DIS_M1)
HD1_P: J22.3 (D+`), U11.2 (USBDP_DN1/PRT_DIS_P1)
HD2_N: J22.6 (D-), U11.3 (USBDM_DN2/PRT_DIS_M2)
HD2_P: J22.7 (D+), U11.4 (USBDP_DN2/PRT_DIS_P2)
HD3_N: U11.6 (USBDM_DN3/PRT_DIS_M3)
HD3_P: U11.7 (USBDP_DN3/PRT_DIS_P3)
HD4_N: U11.8 (USBDM_DN4/PRT_DIS_M4)
HD4_P: U11.9 (USBDP_DN4/PRT_DIS_P4)
Load Output: F3.2
unnamed: C13.1, U9.4 (CT), U9.5 (CT)
unnamed: C14.1, U11.33 (XTALIN/CLKIN), Y1.1
unnamed: C15.1, U11.32 (XTALOUT), Y1.2
unnamed: C46.1, J24.4 (VDD), U23.1 (VOUT)
unnamed: C46.2, J24.6 (VSS), U23.2 (GND)
unnamed: D17.1 (A), F3.1
unnamed: D17.2 (K), R37.2
unnamed: J21.1 (VBUS), R49.1
unnamed: J24.9 (DET_B), R34.2
unnamed: J24.10 (DET_A), R31.2
unnamed: R46.1, U9.16 (LEDG_K)
unnamed: R47.1, U9.18 (LEDY_K)
unnamed: R50.1, U11.24 (SCL/SMBCLK/CFG_SEL0)
unnamed: R51.1, U11.22 (SDA/SMBDATA/NON_REM1)
unnamed: R52.1, U11.28 (SUSP_IND/LOCAL_PWR/NON_REM0)
unnamed: R53.2, U11.35 (RBIAS)
unnamed: R54.1, U11.25 (HS_IND/CFG_SEL1)
unnamed: R55.1, U13.5 (ILIM)
unnamed: U12.1 (D1+), U12.10
unnamed: U12.2 (D1-), U12.9
PCIE_CLK_N: J25.A14 (REFCLK-)
PCIE_CLK_P: J25.A13 (REFCLK+)
PCIE_CLK_nREQ: J25.B12 (nCLKREQ)
PCIE_RX_N: J25.A17 (PERN0)
PCIE_RX_P: J25.A16 (PERP0)
PCIE_TX_N: J25.B15 (PETN0)
PCIE_TX_P: J25.B14 (PETP0)
PCIE_nRST: J25.A11 (nPERST)
PCIe-VCC: D30.1 (K), J25.A2 (+12V), J25.A3 (+12V), J25.B1 (+12v), J25.B2 (+12v), J25.B3 (+12v), R37.1
PWR1: U11.12 (PRTPWR1/BC_EN1), U13.3 (EN)
Reserved: R34.1
SD_CLK: J24.5 (CLK)
SD_CMD: J24.3 (CMD)
SD_DAT0: J24.7 (DAT0)
SD_DAT1: J24.8 (DAT1)
SD_DAT2: J24.1 (DAT2)
SD_DAT3: J24.2 (DAT3/CD)
SD_PWR_ON: R30.1, U23.4 (EN)
TR0_TAP: J20.3, U9.11 (VC1)
TR1_TAP: J20.1, U9.12 (VC2)
TR2_TAP: J20.2, U9.13 (VC3)
TR3_TAP: J20.4, U9.14 (VC4)
TRD0_N: U8.4 (D2+), U8.7, U9.2 (TRD0-)
TRD0_P: U8.5 (D2-), U8.6, U9.1 (TRD0+)
TRD1_N: U8.2 (D1-), U8.9, U9.6 (TRD1-)
TRD1_P: U8.1 (D1+), U8.10, U9.3 (TRD1+)
TRD2_N: U7.4 (D2+), U7.7, U9.8 (TRD2-)
TRD2_P: U7.5 (D2-), U7.6, U9.7 (TRD2+)
TRD3_N: U7.2 (D1-), U7.9, U9.10 (TRD3-)
TRD3_P: U7.1 (D1+), U7.10, U9.9 (TRD3+)
USB2_N: U10.4 (D_N)
USB2_P: U10.3 (D_P)
USBD_N: J21.2 (D-), U10.8 (HSD1_M), U12.4 (D2+), U12.7
USBD_P: J21.3 (D+), U10.9 (HSD1_P), U12.5 (D2-), U12.6
USBH_N: U10.6 (HSD0_M), U11.30 (USBDM_UP)
USBH_P: U10.7 (HSD0_P), U11.31 (USBDP_UP)
USB_OTG: R48.1, R49.2, U10.2 (SEL)
VBUS: C25.1, C26.1, C27.1, C28.1, C29.1, J22.1 (VBUS`), J22.5 (VBUS), U13.6 (OUT)
nEXTRST: U11.26 (RESET_N)
nOCS1: U11.13 (OCS_N1), U11.17 (OCS_N2), U11.19 (OCS_N3), U11.21 (OCS_N4), U13.4 (nFault)

Notes on the sheet:
Ethernet POE Protection
Micro USB ESD protection
Current Limit switch
Ethernet
Stacked USB connectors
If a cable in plugged into the uUSB socket the CM4 becomes a usb device
USB 2.0 Hub
POE Header
