cruunnerr/CrallyBoard/kicad files/input_output.kicad_sch

## KiCad design kicad files/input_output.kicad_sch (2022-10-13)

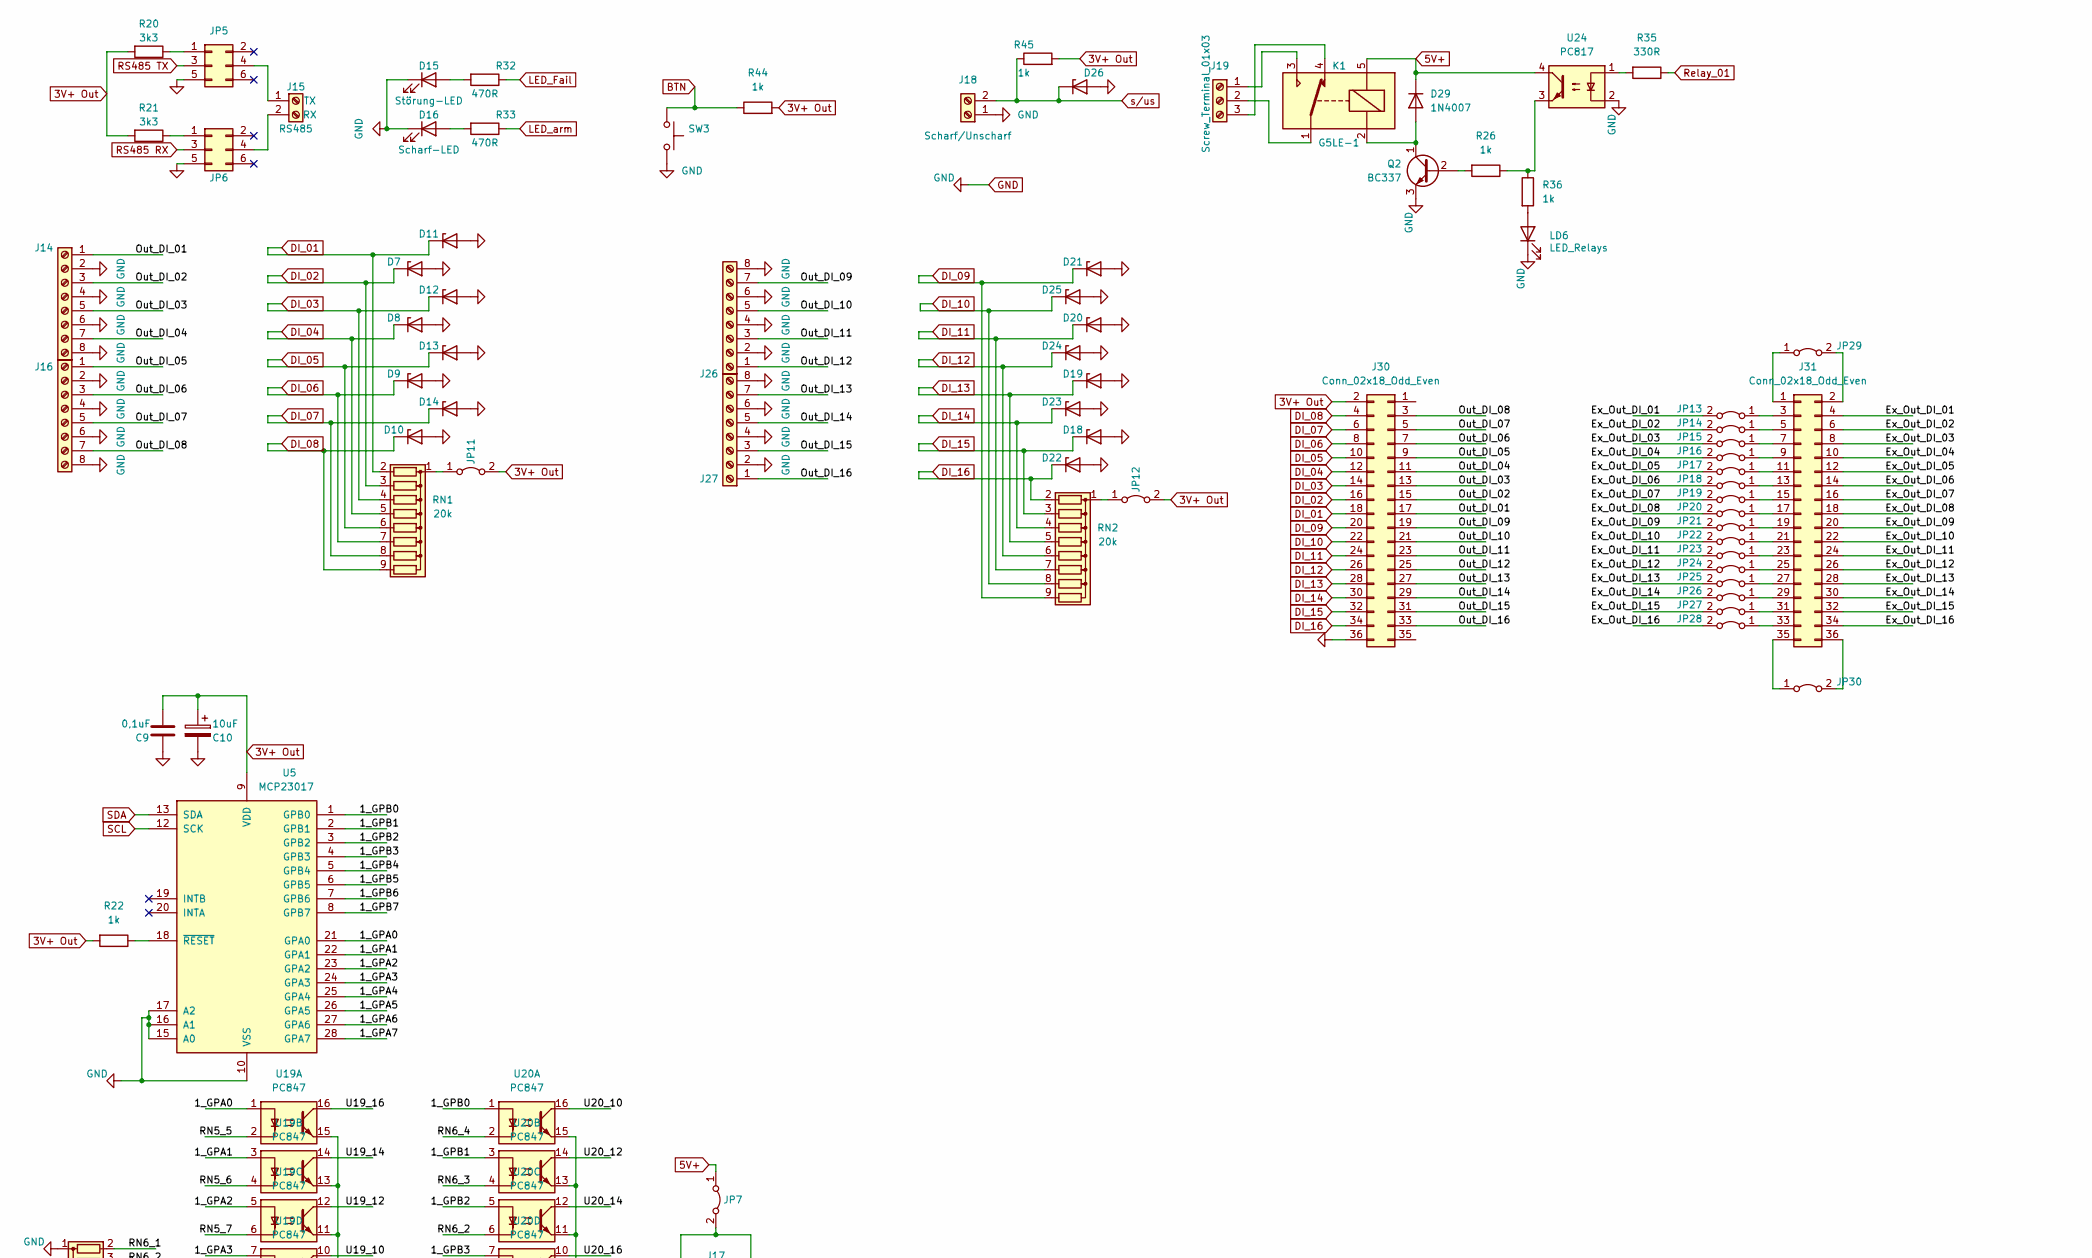
[picture p14: schematic input_output.kicad_sch, part in row 1, column 1]

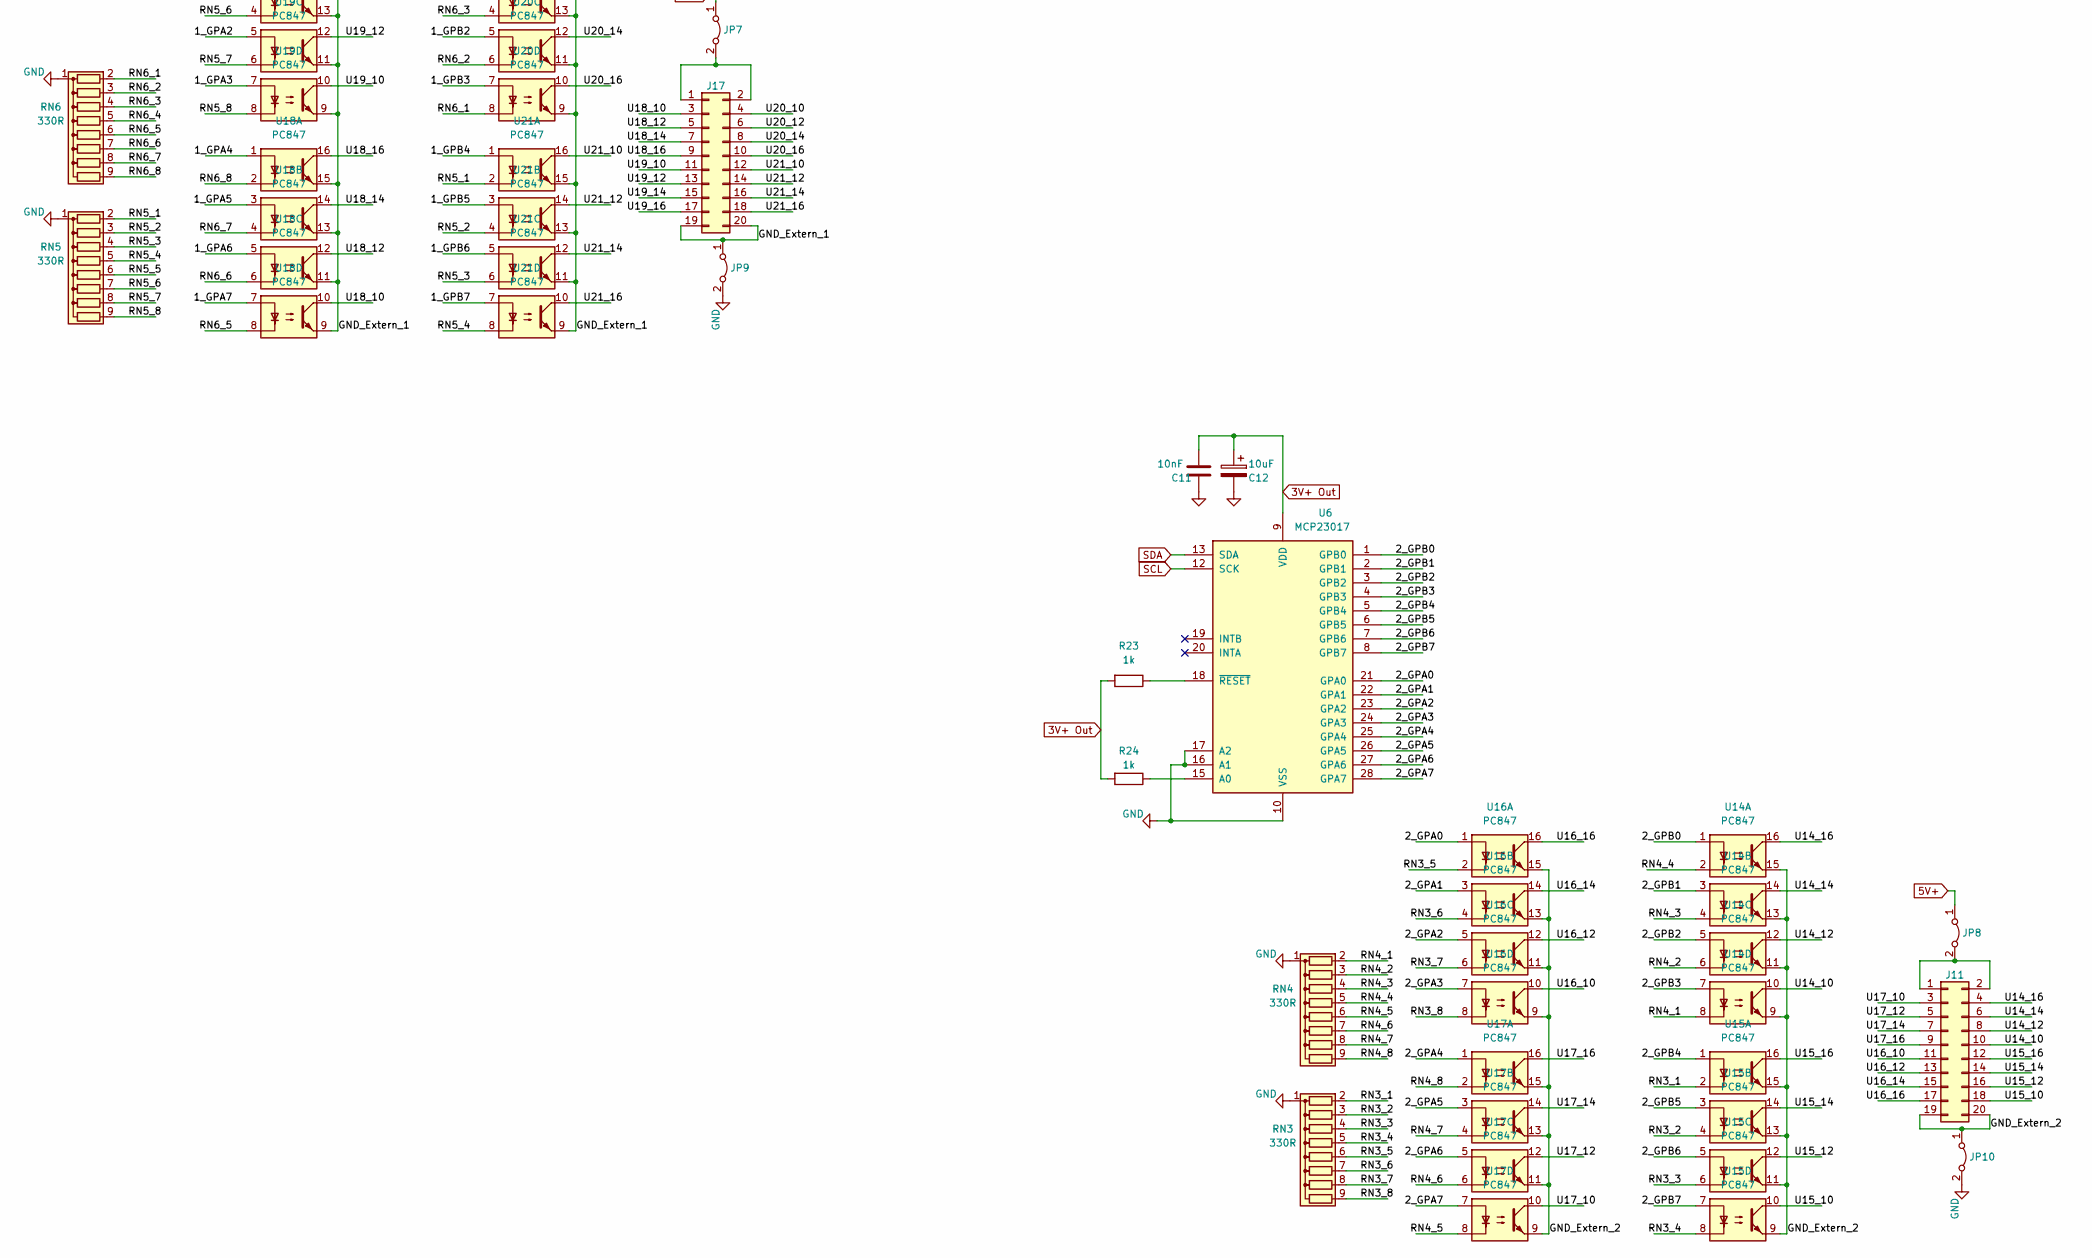
[picture p15: schematic input_output.kicad_sch, part in row 2, column 1]

Parts:
C9: 0,1uF; CP_Radial_Tantal_D4.5mm_P2.50mm
C10, C12: 10uF; CP_Elec_8x6.2
C11: 10nF; CP_Radial_Tantal_D4.5mm_P2.50mm
D7, D8, D9, D10, D11, D12, D13, D14, D18, D19, D20, D21, D22, D23, D24, D25, D26: 1N47xxA; D_MiniMELF
D15: Störungs-LED; LED_0805_2012Metric_Pad1.15x1.40mm_HandSolder
D16: Scharf-LED; LED_0805_2012Metric_Pad1.15x1.40mm_HandSolder
D29: 1N4007; D_DO-41_SOD81_P10.16mm_Horizontal
J11, J17: Conn_02x10_Odd_Even; IDC-Header_2x10_P2.54mm_Vertical
J14, J16, J26, J27: Screw_Terminal_01x08; 250-408
J15: RS485; PhoenixContact_MCV_1,5_2-G-3.5_1x02_P3.50mm_Vertical
J18: Screw_Terminal_01x02; TerminalBlock_WAGO_804-102_1x02_P5.00mm_45Degree
J19: Screw_Terminal_01x03; TerminalBlock_Phoenix_MKDS-1,5-3-5.08_1x03_P5.08mm_Horizont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
J30: Conn_02x18_Odd_Even; PinSocket_2x18_P2.54mm_Vertical
J31: Conn_02x18_Odd_Even; PinHeader_2x18_P2.54mm_Vertical
JP5, JP6: Conn_02x03_Odd_Even; PinHeader_2x03_P2.54mm_Vertical
JP7, JP8: Jumper_2_Bridged; PinHeader_1x02_P2.54mm_Vertical
JP9, JP10, JP11, JP12, JP13, JP14, JP15, JP16, JP17, JP18, JP19, JP20, JP21, JP22, JP23, JP24, JP25, JP26, JP27, JP28, JP29, JP30: Jumper_2_Bridged; SolderJumper-2_P1.3mm_Open_RoundedPad1.0x1.5mm
K1: G5LE-1; Relay_SPDT_Omron-G5LE-1
LD6: LED_Relays; LED_0805_2012Metric_Pad1.15x1.40mm_HandSolder
Q2: BC337; TO-92_Inline
R20, R21: 3k3; R_0805_2012Metric_Pad1.20x1.40mm_HandSolder
R22, R23, R24, R26, R36, R44, R45: 1k; R_0805_2012Metric_Pad1.20x1.40mm_HandSolder
R32, R33: 470R; R_0805_2012Metric_Pad1.20x1.40mm_HandSolder
R35: 330R; R_0805_2012Metric_Pad1.20x1.40mm_HandSolder
RN1, RN2: 20k; R_Array_SIP9
RN3, RN4, RN5, RN6: 330R; R_Array_SIP9
SW3: SW_PUSH_6mm_H5mm
U5, U6: MCP23017; SOIC127P1030X265-28N
U14, U15, U16, U17, U18, U19, U20, U21: PC847; DIP-16_W7.62mm
U24: PC817; DIP-4_W7.62mm; MPN HCPL-817-00AE

Connections:
1_GPA0: U5.21 (GPA0), U19.1
1_GPA1: U5.22 (GPA1), U19.3
1_GPA2: U5.23 (GPA2), U19.5
1_GPA3: U5.24 (GPA3), U19.7
1_GPA4: U5.25 (GPA4), U18.1
1_GPA5: U5.26 (GPA5), U18.3
1_GPA6: U5.27 (GPA6), U18.5
1_GPA7: U5.28 (GPA7), U18.7
1_GPB0: U5.1 (GPB0), U20.1
1_GPB1: U5.2 (GPB1), U20.3
1_GPB2: U5.3 (GPB2), U20.5
1_GPB3: U5.4 (GPB3), U20.7
1_GPB4: U5.5 (GPB4), U21.1
1_GPB5: U5.6 (GPB5), U21.3
1_GPB6: U5.7 (GPB6), U21.5
1_GPB7: U5.8 (GPB7), U21.7
2_GPA0: U6.21 (GPA0), U16.1
2_GPA1: U6.22 (GPA1), U16.3
2_GPA2: U6.23 (GPA2), U16.5
2_GPA3: U6.24 (GPA3), U16.7
2_GPA4: U6.25 (GPA4), U17.1
2_GPA5: U6.26 (GPA5), U17.3
2_GPA6: U6.27 (GPA6), U17.5
2_GPA7: U6.28 (GPA7), U17.7
2_GPB0: U6.1 (GPB0), U14.1
2_GPB1: U6.2 (GPB1), U14.3
2_GPB2: U6.3 (GPB2), U14.5
2_GPB3: U6.4 (GPB3), U14.7
2_GPB4: U6.5 (GPB4), U15.1
2_GPB5: U6.6 (GPB5), U15.3
2_GPB6: U6.7 (GPB6), U15.5
2_GPB7: U6.8 (GPB7), U15.7
3V+ Out: C9.2, C10.1, C11.2, C12.1, J30.2, JP11.2 (B), JP12.2 (B), R20.2, R21.2, R22.2, R23.2, R24.2, R44.2, R45.2, U5.9 (VDD), U6.9 (VDD)
5V+: D29.1 (K), JP7.1 (A), JP8.1 (A), K1.5, U24.4
BTN: R44.1, SW3.1
DI_01: D11.1 (K), J30.18, RN1.2 (R1)
DI_02: D7.1 (K), J30.16, RN1.3 (R2)
DI_03: D12.1 (K), J30.14, RN1.4 (R3)
DI_04: D8.1 (K), J30.12, RN1.5 (R4)
DI_05: D13.1 (K), J30.10, RN1.6 (R5)
DI_06: D9.1 (K), J30.8, RN1.7 (R6)
DI_07: D14.1 (K), J30.6, RN1.8 (R7)
DI_08: D10.1 (K), J30.4, RN1.9 (R8)
DI_09: D21.1 (K), J30.20, RN2.9 (R8)
DI_10: D25.1 (K), J30.22, RN2.8 (R7)
DI_11: D20.1 (K), J30.24, RN2.7 (R6)
DI_12: D24.1 (K), J30.26, RN2.6 (R5)
DI_13: D19.1 (K), J30.28, RN2.5 (R4)
DI_14: D23.1 (K), J30.30, RN2.4 (R3)
DI_15: D18.1 (K), J30.32, RN2.3 (R2)
DI_16: D22.1 (K), J30.34, RN2.2 (R1)
Ex_Out_DI_01: J31.4, JP13.2 (B)
Ex_Out_DI_02: J31.6, JP14.2 (B)
Ex_Out_DI_03: J31.8, JP15.2 (B)
Ex_Out_DI_04: J31.10, JP16.2 (B)
Ex_Out_DI_05: J31.12, JP17.2 (B)
Ex_Out_DI_06: J31.14, JP18.2 (B)
Ex_Out_DI_07: J31.16, JP19.2 (B)
Ex_Out_DI_08: J31.18, JP20.2 (B)
Ex_Out_DI_09: J31.20, JP21.2 (B)
Ex_Out_DI_10: J31.22, JP22.2 (B)
Ex_Out_DI_11: J31.24, JP23.2 (B)
Ex_Out_DI_12: J31.26, JP24.2 (B)
Ex_Out_DI_13: J31.28, JP25.2 (B)
Ex_Out_DI_14: J31.30, JP26.2 (B)
Ex_Out_DI_15: J31.32, JP27.2 (B)
Ex_Out_DI_16: J31.34, JP28.2 (B)
GND: C9.1, C10.2, C11.1, C12.2, D7.2 (A), D8.2 (A), D9.2 (A), D10.2 (A), D11.2 (A), D12.2 (A), D13.2 (A), D14.2 (A), D15.1 (K), D16.1 (K), D18.2 (A), D19.2 (A), D20.2 (A), D21.2 (A), D22.2 (A), D23.2 (A), D24.2 (A), D25.2 (A), D26.2 (A), J14.2, J14.4, J14.6, J14.8, J16.2, J16.4, J16.6, J16.8, J18.1, J26.2, J26.4, J26.6, J26.8, J27.2, J27.4, J27.6, J27.8, J30.36, JP5.5, JP6.5, JP9.2 (B), JP10.2 (B), LD6.1 (K), Q2.3 (E), RN3.1 (common), RN4.1 (common), RN5.1 (common), RN6.1 (common), SW3.2, U5.10 (VSS), U5.15 (A0), U5.16 (A1), U5.17 (A2), U6.10 (VSS), U6.16 (A1), U6.17 (A2), U24.2
GND_Extern_1: J17.19, J17.20, JP9.1 (A), U18.9, U18.11, U18.13, U18.15, U19.9, U19.11, U19.13, U19.15, U20.9, U20.11, U20.13, U20.15, U21.9, U21.11, U21.13, U21.15
GND_Extern_2: J11.19, J11.20, JP10.1 (A), U14.9, U14.11, U14.13, U14.15, U15.9, U15.11, U15.13, U15.15, U16.9, U16.11, U16.13, U16.15, U17.9, U17.11, U17.13, U17.15
LED_Fail: R32.1
LED_arm: R33.1
unnamed: D15.2 (A), R32.2
unnamed: D16.2 (A), R33.2
unnamed: D29.2 (A), K1.2, Q2.1 (C)
unnamed: J11.1, J11.2, JP8.2 (B)
unnamed: J15.1, JP5.4
unnamed: J15.2, JP6.4
unnamed: J17.1, J17.2, JP7.2 (B)
unnamed: J19.1, K1.3
unnamed: J19.2, K1.1
unnamed: J19.3, K1.4
unnamed: J31.1, JP29.1 (A)
unnamed: J31.2, JP29.2 (B)
unnamed: J31.3, JP13.1 (A)
unnamed: J31.5, JP14.1 (A)
unnamed: J31.7, JP15.1 (A)
unnamed: J31.9, JP16.1 (A)
unnamed: J31.11, JP17.1 (A)
unnamed: J31.13, JP18.1 (A)
unnamed: J31.15, JP19.1 (A)
unnamed: J31.17, JP20.1 (A)
unnamed: J31.19, JP21.1 (A)
unnamed: J31.21, JP22.1 (A)
unnamed: J31.23, JP23.1 (A)
unnamed: J31.25, JP24.1 (A)
unnamed: J31.27, JP25.1 (A)
unnamed: J31.29, JP26.1 (A)
unnamed: J31.31, JP27.1 (A)
unnamed: J31.33, JP28.1 (A)
unnamed: J31.35, JP30.1 (A)
unnamed: J31.36, JP30.2 (B)
unnamed: JP5.1, R20.1
unnamed: JP6.1, R21.1
unnamed: JP11.1 (A), RN1.1 (common)
unnamed: JP12.1 (A), RN2.1 (common)
unnamed: LD6.2 (A), R36.2
unnamed: Q2.2 (B), R26.2
unnamed: R22.1, U5.18 (~RESET)
unnamed: R23.1, U6.18 (~RESET)
unnamed: R24.1, U6.15 (A0)
unnamed: R26.1, R36.1, U24.3
unnamed: R35.2, U24.1
Out_DI_01: J14.1, J30.17
Out_DI_02: J14.3, J30.15
Out_DI_03: J14.5, J30.13
Out_DI_04: J14.7, J30.11
Out_DI_05: J16.1, J30.9
Out_DI_06: J16.3, J30.7
Out_DI_07: J16.5, J30.5
Out_DI_08: J16.7, J30.3
Out_DI_09: J26.7, J30.19
Out_DI_10: J26.5, J30.21
Out_DI_11: J26.3, J30.23
Out_DI_12: J26.1, J30.25
Out_DI_13: J27.7, J30.27
Out_DI_14: J27.5, J30.29
Out_DI_15: J27.3, J30.31
Out_DI_16: J27.1, J30.33
RN3_1: RN3.2 (R1), U15.2
RN3_2: RN3.3 (R2), U15.4
RN3_3: RN3.4 (R3), U15.6
RN3_4: RN3.5 (R4), U15.8
RN3_5: RN3.6 (R5), U16.2
RN3_6: RN3.7 (R6), U16.4
RN3_7: RN3.8 (R7), U16.6
RN3_8: RN3.9 (R8), U16.8
RN4_1: RN4.2 (R1), U14.8
RN4_2: RN4.3 (R2), U14.6
RN4_3: RN4.4 (R3), U14.4
RN4_4: RN4.5 (R4), U14.2
RN4_5: RN4.6 (R5), U17.8
RN4_6: RN4.7 (R6), U17.6
RN4_7: RN4.8 (R7), U17.4
RN4_8: RN4.9 (R8), U17.2
RN5_1: RN5.2 (R1), U21.2
RN5_2: RN5.3 (R2), U21.4
RN5_3: RN5.4 (R3), U21.6
RN5_4: RN5.5 (R4), U21.8
RN5_5: RN5.6 (R5), U19.2
RN5_6: RN5.7 (R6), U19.4
RN5_7: RN5.8 (R7), U19.6
RN5_8: RN5.9 (R8), U19.8
RN6_1: RN6.2 (R1), U20.8
RN6_2: RN6.3 (R2), U20.6
RN6_3: RN6.4 (R3), U20.4
RN6_4: RN6.5 (R4), U20.2
RN6_5: RN6.6 (R5), U18.8
RN6_6: RN6.7 (R6), U18.6
RN6_7: RN6.8 (R7), U18.4
RN6_8: RN6.9 (R8), U18.2
RS485 RX: JP6.3
RS485 TX: JP5.3
Relay_01: R35.1
SCL: U5.12 (SCK), U6.12 (SCK)
SDA: U5.13 (SDA), U6.13 (SDA)
U14_10: J11.10, U14.10
U14_12: J11.8, U14.12
U14_14: J11.6, U14.14
U14_16: J11.4, U14.16
U15_10: J11.18, U15.10
U15_12: J11.16, U15.12
U15_14: J11.14, U15.14
U15_16: J11.12, U15.16
U16_10: J11.11, U16.10
U16_12: J11.13, U16.12
U16_14: J11.15, U16.14
U16_16: J11.17, U16.16
U17_10: J11.3, U17.10
U17_12: J11.5, U17.12
U17_14: J11.7, U17.14
U17_16: J11.9, U17.16
U18_10: J17.3, U18.10
U18_12: J17.5, U18.12
U18_14: J17.7, U18.14
U18_16: J17.9, U18.16
U19_10: J17.11, U19.10
U19_12: J17.13, U19.12
U19_14: J17.15, U19.14
U19_16: J17.17, U19.16
U20_10: J17.4, U20.16
U20_12: J17.6, U20.14
U20_14: J17.8, U20.12
U20_16: J17.10, U20.10
U21_10: J17.12, U21.16
U21_12: J17.14, U21.14
U21_14: J17.16, U21.12
U21_16: J17.18, U21.10
s/us: D26.1 (K), J18.2, R45.1
