cruunnerr/CrallyBoard/kicad files/peripherie.kicad_sch

## KiCad design kicad files/peripherie.kicad_sch (2022-10-13)

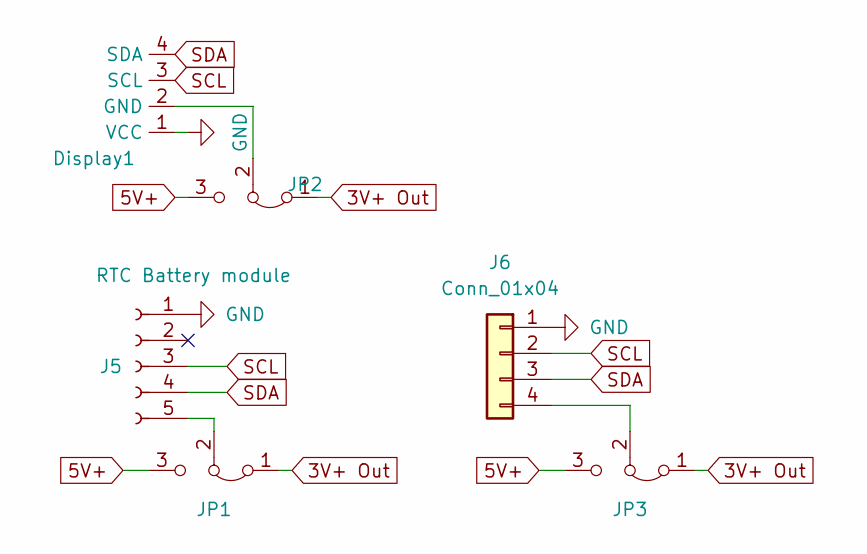
[picture p16: schematic peripherie.kicad_sch]

Parts:
Display1: i2c_display_oled_0.96; OLED_SSD1306_I2C_0.96
J5: RTC Battery module; PinHeader_1x05_P2.54mm_Vertical
J6: Conn_01x04; PinHeader_1x04_P2.54mm_Vertical
JP1, JP2, JP3: Jumper_3_Bridged12; PinHeader_1x03_P2.54mm_Vertical

Connections:
3V+ Out: JP1.1 (A), JP2.1 (A), JP3.1 (A)
5V+: JP1.3 (B), JP2.3 (B), JP3.3 (B)
GND: Display1.1 (VCC), J5.1, J6.1
unnamed: Display1.2 (GND), JP2.2 (C)
unnamed: J5.5, JP1.2 (C)
unnamed: J6.4, JP3.2 (C)
SCL: Display1.3 (SCL), J5.3, J6.2
SDA: Display1.4 (SDA), J5.4, J6.3
