cruunnerr/CrallyBoard/kicad files/power.kicad_sch

## KiCad design kicad files/power.kicad_sch (2022-10-13)

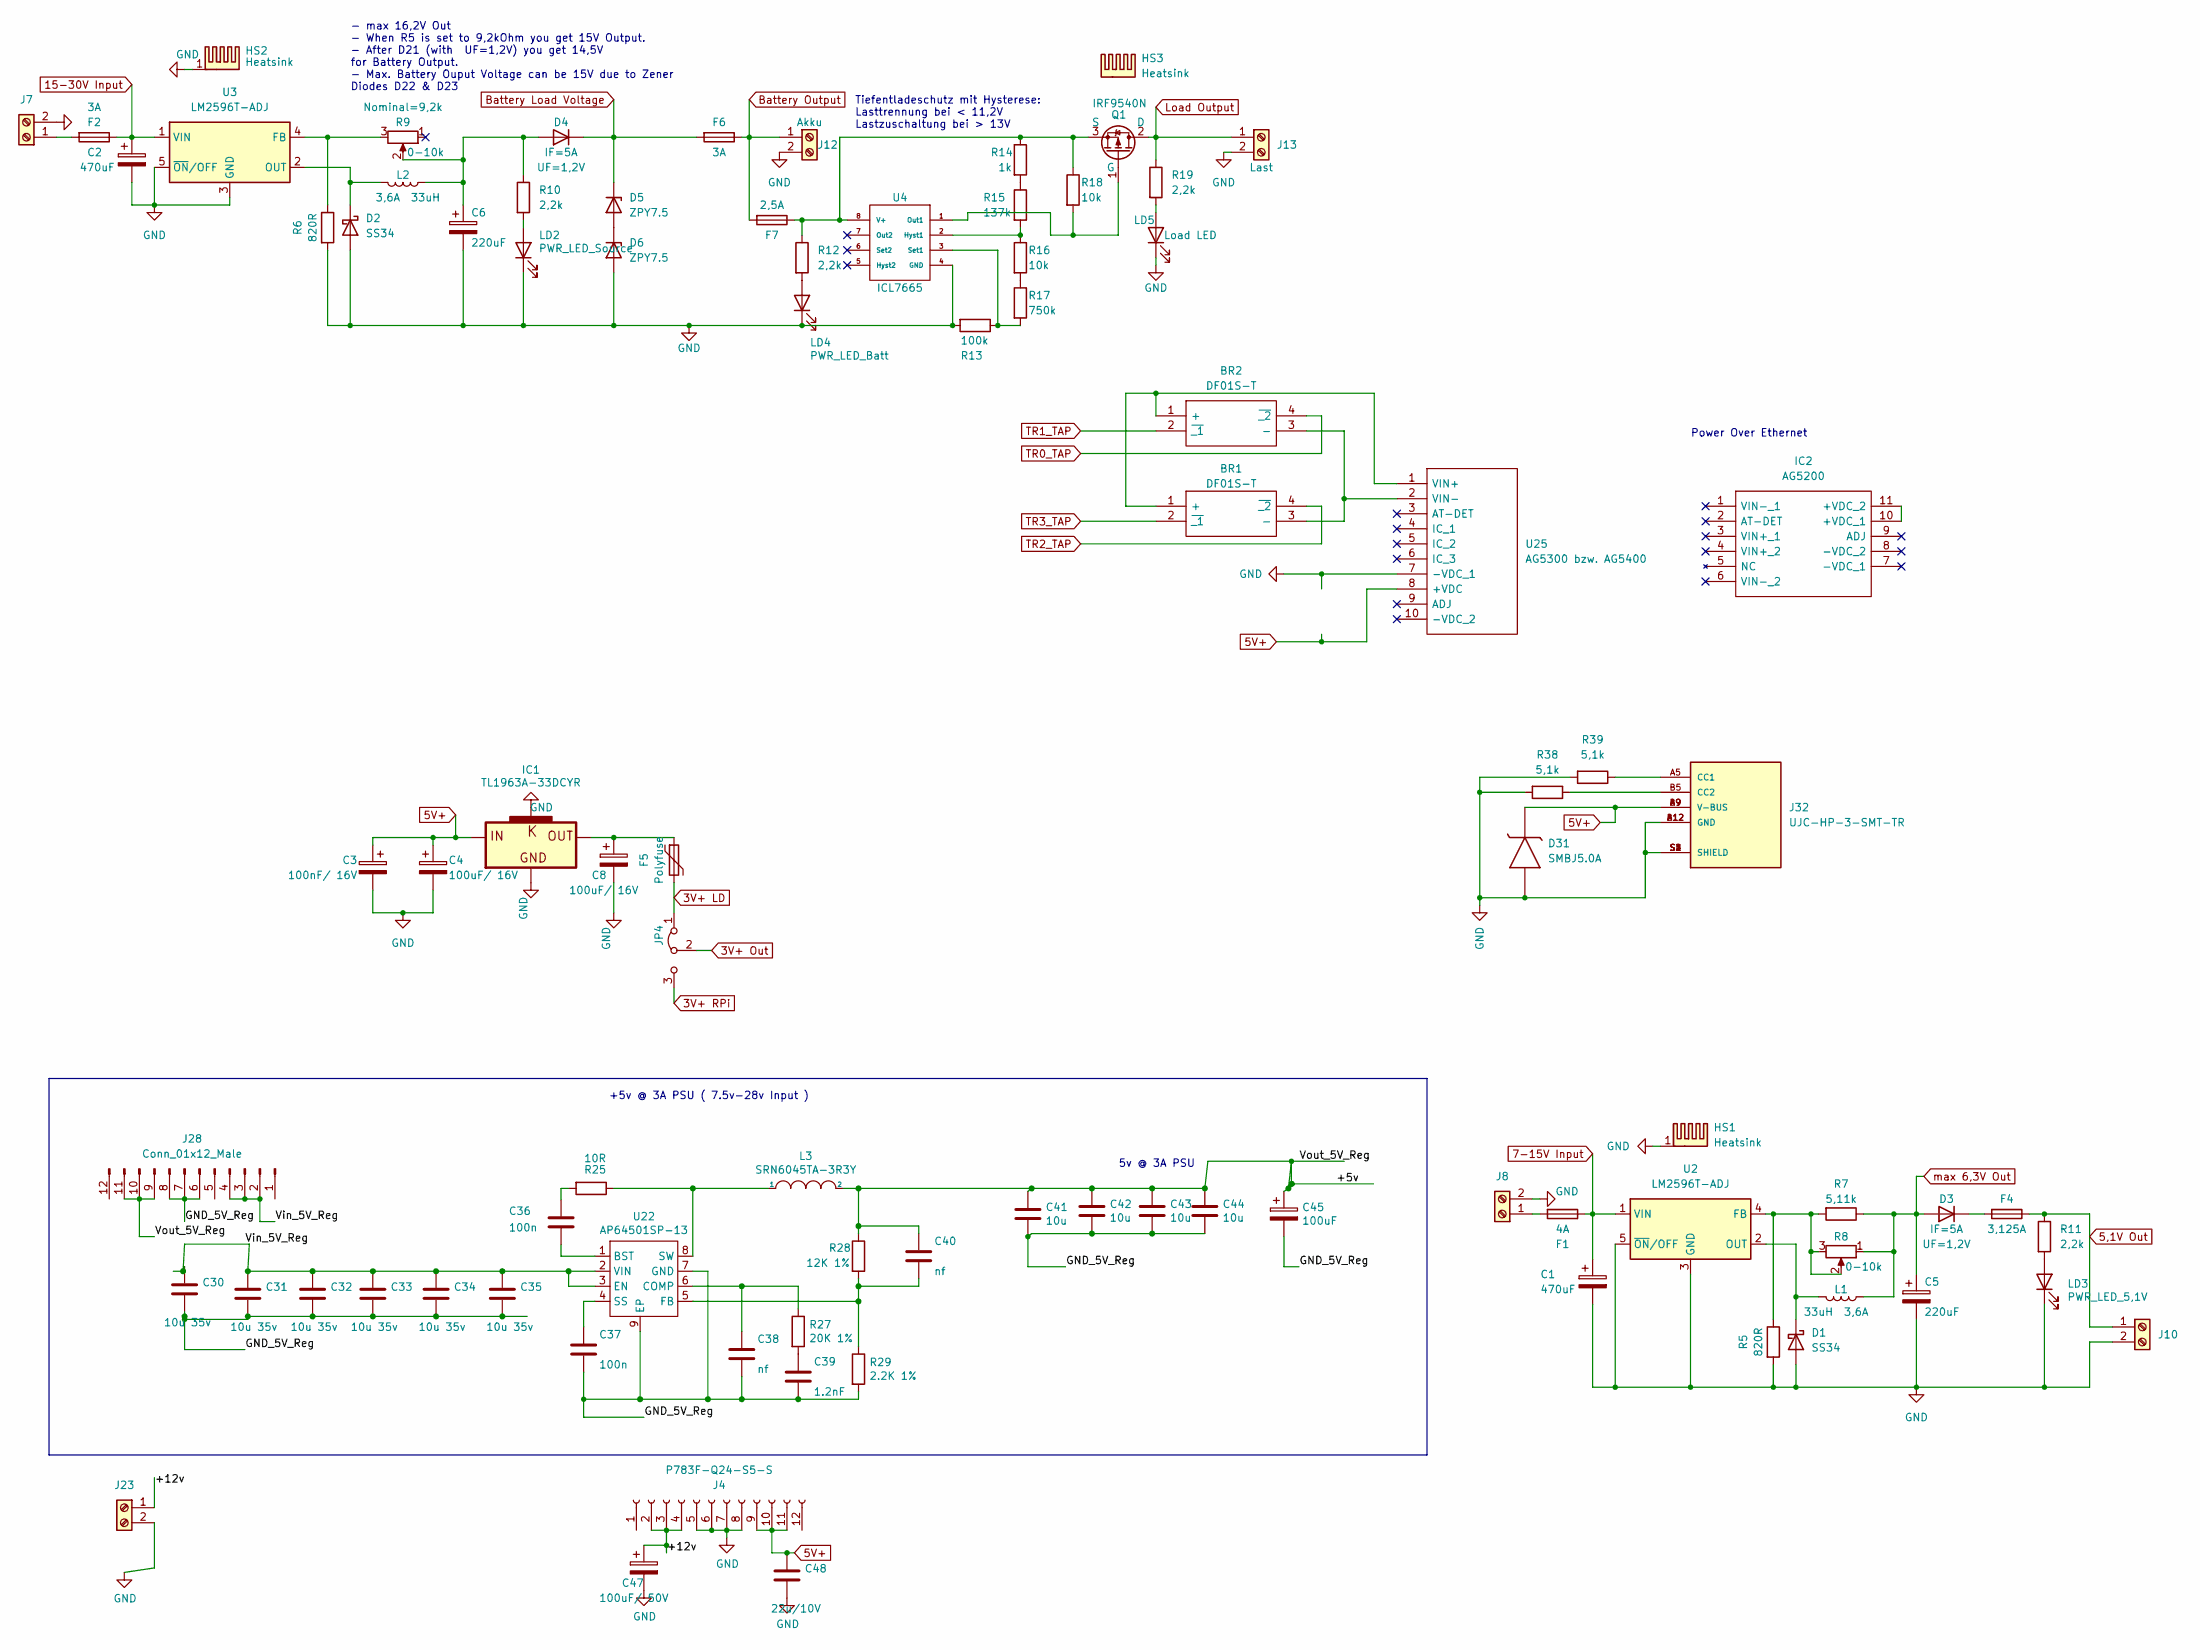
[picture p17: schematic power.kicad_sch]

Parts:
BR1, BR2: DF01S-T; SOP510P1040X293-4N; Manufacturer_Part_Number DF01S-T; Mouser Part Number 621-DF01ST
C1: 470uF; CP_Elec_10x10
C2: 470uF; CP_Radial_D10.0mm_P5.00mm
C3: 100nF/ 16V; C_0805_2012Metric; Mouser Part Number 667-ECP-U1C104MA5
C4, C8: 100uF/ 16V; CP_Elec_8x6.2; Mouser Part Number 667-EEE-1CA101P
C5, C6: 220uF; CP_Elec_10x10
C30, C31, C32, C33, C34, C35: 10u 35v; C_0805_2012Metric; Part Description 10uF 10% or 20% 35V Ceramic Capacitor X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
C36, C37: 100n; C_0805_2012Metric; Part Description 0.1uF 10% 16V Ceramic Capacitor X7R 040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
C38: nf; C_0805_2012Metric
C39: 1.2nF; C_0805_2012Metric; Part Description 1200pF 10% 10V Ceramic Capacitor X5R 04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
C40: nf; C_0805_2012Metric; Part Description 220 pF, 50 V, 0402 [1005 Metric], ± 5%,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
C41, C42, C43, C44: 10u; C_0805_2012Metric; Part Description 10uF 10% 10V Ceramic Capacitor X7R 0805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
C45: 100uF; CP_EIA-7343-31_Kemet-D; Part Description Capacitor, SP-Cap, 100u, 6.3V, 15mR ESR
C47: 100uF/ 50V; CP_Elec_8x6.2; Mouser Part Number 667-EEE-1CA101P
C48: 22u/10V; C_0805_2012Metric; Part Description 10uF 10% or 20% 35V Ceramic Capacitor X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
D1, D2: SS34; D_DO-15_P5.08mm_Vertical_KathodeUp
D3, D4: IF=5A; D_DO-15_P5.08mm_Vertical_KathodeUp
D5, D6: ZPY7.5; D_MiniMELF
D31: SMBJ5.0A; MANUFACTURER_PART_NUMBER SMBJ5.0CA
F1: 4A; Fuseholder5x20_horiz_open_lateral_Type-II
F2, F6: 3A; Fuseholder5x20_horiz_open_lateral_Type-II
F4: 3,125A; Fuseholder5x20_horiz_open_lateral_Type-II
F5: Polyfuse; Fuse_BelFuse_0ZRE0005FF_L8.3mm_W3.8mm
F7: 2,5A; Fuseholder5x20_horiz_open_lateral_Type-II
HS1, HS2: Heatsink; Heatsink_Fischer_SK104-STC-STIC_35x13mm_2xDrill2.5mm
HS3: Heatsink; Heatsink_SK95
IC1: TL1963A-33DCYR; SOT223; Mouser Part Number 595-TL1963A-33DCYR
IC2: AG5200; Mouser Part Number 480-AG5200
J4: P783F-Q24-S5-S; PinSocket_1x12_P2.54mm_Vertical; Mouser Part Number 490-P783F-Q24-S5-S
J7, J8, J10, J12, J13, J23: Screw_Terminal_01x02; TerminalBlock_WAGO_804-102_1x02_P5.00mm_45Degree
J28: Conn_01x12_Male; PinSocket_1x12_P2.54mm_Vertical
J32: UJC-HP-3-SMT-TR; CUI_UJC-HP-3-SMT-TR; PARTREV 04/30/2020
JP4: Jumper_3_Bridged12; PinHeader_1x03_P2.54mm_Vertical
L1, L2: 33uH; L_Axial_L26.0mm_D10.0mm_P7.62mm_Vertical_Fastron_77A
L3: SRN6045TA-3R3Y; L_Bourns_SRN6045TA; Part Description 3.3µH Semi-Shielded Wirewound Inductor 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
LD2: PWR_LED_Source; LED_0805_2012Metric_Pad1.15x1.40mm_HandSolder
LD3: PWR_LED_5,1V; LED_0805_2012Metric_Pad1.15x1.40mm_HandSolder
LD4: PWR_LED_Batt; LED_0805_2012Metric_Pad1.15x1.40mm_HandSolder
LD5: Load LED; LED_0805_2012Metric_Pad1.15x1.40mm_HandSolder
Q1: IRF9540N; TO-220-3_Vertical
R5, R6: 820R; R_0805_2012Metric_Pad1.20x1.40mm_HandSolder
R7: 5,11k; R_0805_2012Metric_Pad1.20x1.40mm_HandSolder
R8: Nominal=21k; Potentiometer_Bourns_3296W_Vertical
R9: Nominal=9,2k; Potentiometer_Bourns_3296W_Vertical
R10, R11, R12, R19: 2,2k; R_0805_2012Metric_Pad1.20x1.40mm_HandSolder
R13: 100k; R_0805_2012Metric_Pad1.20x1.40mm_HandSolder
R14: 1k; R_0805_2012Metric_Pad1.20x1.40mm_HandSolder
R15: 137k; R_0805_2012Metric_Pad1.20x1.40mm_HandSolder
R16, R18: 10k; R_0805_2012Metric_Pad1.20x1.40mm_HandSolder
R17: 750k; R_0805_2012Metric_Pad1.20x1.40mm_HandSolder
R25: 10R; R_0805_2012Metric; Part Description Resistor 10R M1005 1% 63mW
R27: 20K 1%; R_0805_2012Metric; Part Description Resistor 20K M1005 1% 63mW
R28: 12K 1%; R_0805_2012Metric; Part Description Resistor 12K M1005 1% 63mW
R29: 2.2K 1%; R_0805_2012Metric; Part Description Resistor 2.2K M1005 1% 63mW
R38, R39: 5,1k; R_0805_2012Metric_Pad1.20x1.40mm_HandSolder
U2, U3: LM2596T-ADJ; TO-220-5_P3.4x3.7mm_StaggerOdd_Lead3.8mm_Vertical
U4: ICL7665; DIP-8_W7.62mm_Socket
U22: AP64501SP-13; SOIC-8-1EP_3.9x4.9mm_P1.27mm_EP2.95x4.9mm_Mask2.71x3.4mm_Th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; Part Description Buck Switching Regulator IC Positive Ad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
U25: AG5300 bzw. AG5400; AG5300; Manufacturer_Part_Number AG5300; Mouser Part Number 480-AG5300

Connections:
3V+ LD: F5.2, JP4.1 (A)
3V+ Out: JP4.2 (C)
3V+ RPi: JP4.3 (B)
5,1V Out: F4.1, J10.1, R11.1
5V+: C3.1, C4.1, C48.1, D31.1, IC1.1, J4.9, J4.10, J4.11, J32.A9 (V-BUS), J32.B9 (V-BUS), U25.8 (+VDC)
7-15V Input: C1.1, F1.1, U2.1 (VIN)
15-30V Input: C2.1, F2.1, U3.1 (VIN)
+5v: C40.1, C41.1, C42.1, C43.1, C44.1, C45.1, J28.9, J28.10, J28.11, L3.2, R28.1
+12v: C47.1, J4.2, J4.3, J4.4, J23.1
Battery Load Voltage: D4.1 (K), D5.1 (K), F6.2
Battery Output: F6.1, F7.2, J12.1
GND: C1.2, C2.2, C3.2, C4.2, C5.2, C6.2, C8.2, C47.2, C48.2, D1.2 (A), D2.2 (A), D6.2 (A), D31.2, HS1.1, HS2.1, IC1.2, IC1.4, J4.5, J4.6, J4.7, J4.8, J7.2, J8.2, J10.2, J12.2, J13.2, J23.2, J32.A12 (GND), J32.B12 (GND), J32.S1 (SHIELD), J32.S2 (SHIELD), J32.S3 (SHIELD), J32.S4 (SHIELD), LD2.1 (K), LD3.1 (K), LD4.1 (K), LD5.1 (K), R5.2, R6.2, R13.2, R38.2, R39.2, U2.3 (GND), U2.5 (~ON/OFF), U3.3 (GND), U3.5 (~ON/OFF), U4.4 (GND), U25.7 (-VDC_1)
GND_5V_Reg: C30.2, C31.2, C32.2, C33.2, C34.2, C35.2, C37.2, C38.2, C39.2, C41.2, C42.2, C43.2, C44.2, C45.2, J28.6, J28.7, J28.8, R29.2, U22.7 (GND), U22.9 (EP)
Load Output: J13.1, Q1.2 (D), R19.1
unnamed: BR1.1 (+), BR2.1 (+), U25.1 (VIN+)
unnamed: BR1.3 (-), BR2.3 (-), U25.2 (VIN-)
unnamed: C6.1, D4.2 (A), L2.2, R9.2, R10.1
unnamed: C8.1, F5.1, IC1.3
unnamed: C36.1, R25.2
unnamed: C36.2, U22.1 (BST)
unnamed: C37.1, U22.4 (SS)
unnamed: C38.1, R27.1, U22.6 (COMP)
unnamed: C39.1, R27.2
unnamed: C40.2, R28.2, R29.1, U22.5 (FB)
unnamed: D1.1 (K), L1.2, U2.2 (OUT)
unnamed: D2.1 (K), L2.1, U3.2 (OUT)
unnamed: D3.2 (K), F4.2
unnamed: D5.2 (A), D6.1 (K)
unnamed: F1.2, J8.1
unnamed: F2.2, J7.1
unnamed: F7.1, Q1.3 (S), R12.1, R14.1, R18.1, U4.8 (V+)
unnamed: IC2.10 (+VDC_1), IC2.11 (+VDC_2)
unnamed: J32.A5 (CC1), R39.1
unnamed: J32.B5 (CC2), R38.1
unnamed: L3.1, R25.1, U22.8 (SW)
unnamed: LD2.2 (A), R10.2
unnamed: LD3.2 (A), R11.2
unnamed: LD4.2 (A), R12.2
unnamed: LD5.2 (A), R19.2
unnamed: Q1.1 (G), R18.2, U4.1 (Out1)
unnamed: R5.1, R7.2, R8.2, R8.3, U2.4 (FB)
unnamed: R6.1, R9.3, U3.4 (FB)
unnamed: R13.1, R17.2, U4.3 (Set1)
unnamed: R14.2, R15.1
unnamed: R15.2, R16.1, U4.2 (Hyst1)
unnamed: R16.2, R17.1
TR0_TAP: BR2.4 (~_2)
TR1_TAP: BR2.2 (~_1)
TR2_TAP: BR1.4 (~_2)
TR3_TAP: BR1.2 (~_1)
Vin_5V_Reg: C30.1, C31.1, C32.1, C33.1, C34.1, C35.1, J28.2, J28.3, J28.4, U22.2 (VIN), U22.3 (EN)
max 6,3V Out: C5.1, D3.1 (A), L1.1, R7.1, R8.1

Notes on the sheet:
Tiefentladeschutz mit Hysterese: Lasttrennung bei < 11,2V Lastzuschaltung bei > 13V
5v @ 3A PSU
+5v @ 3A PSU ( 7.5v-28v Input )
- max 16,2V Out - When R5 is set to 9,2kOhm you get 15V Output. - After D21 (with UF=1,2V) you get 14,5V for Battery Output. - Max. Battery Ouput Voltage can be 15V due to Zener Diodes D22 & D23
Power Over Ethernet
